triplo098/USB-to-Multipurpose-Framework-Expansion-Card/usb_to_multipurpose/usb_to_multipurpose_with_case.png

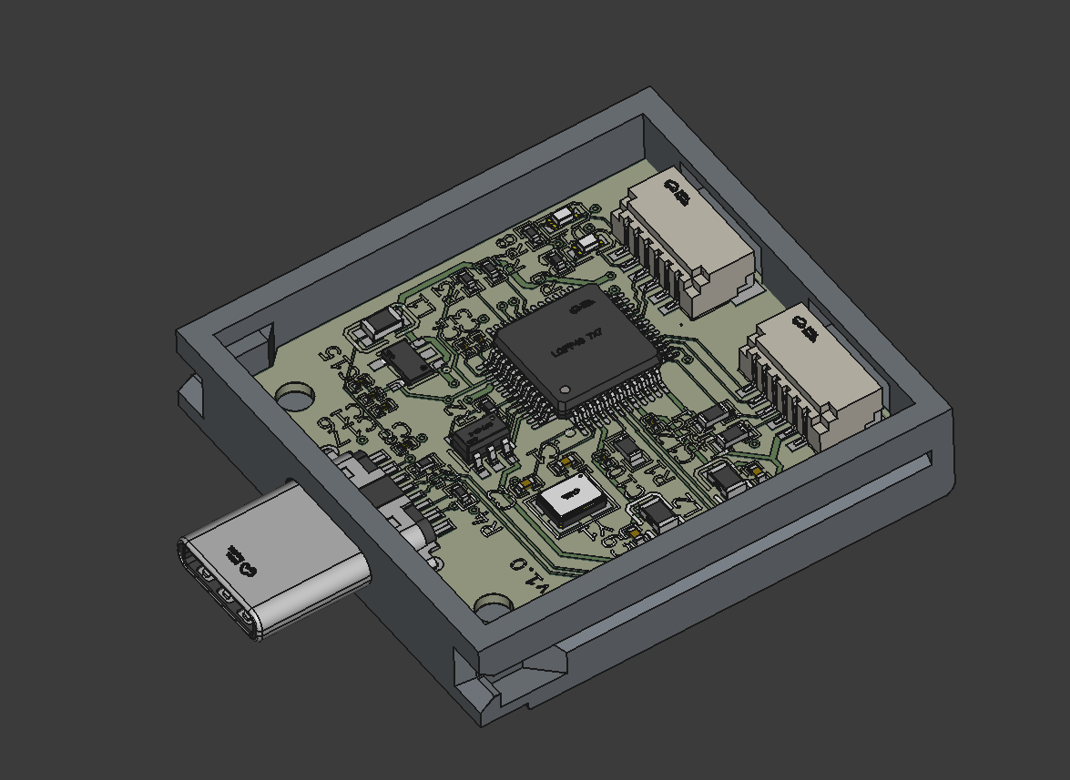
usb_to_multipurpose/usb_to_multipurpose_with_case.png
