triplo098/USB-to-Multipurpose-Framework-Expansion-Card/3D_models/usb_to_multipurpose.stl

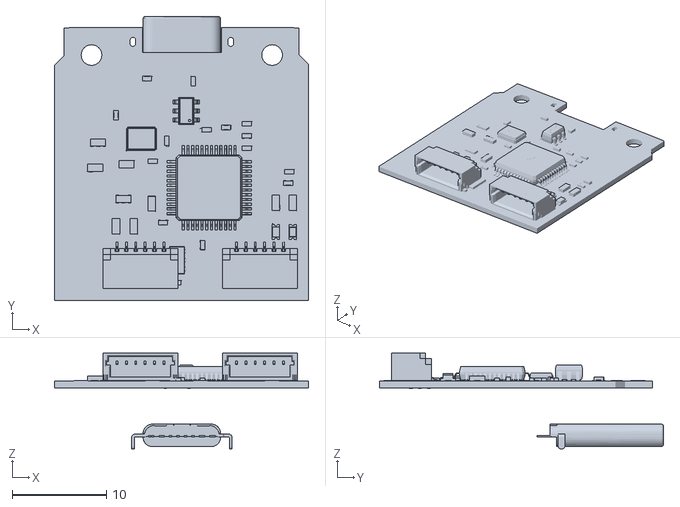
[picture p6: CAD file, 2026-11-10]
3D_models/usb_to_multipurpose.stl
27.0 x 30.2 x 10.2
