triplo098/USB-to-Multipurpose-Framework-Expansion-Card/usb_to_multipurpose/usb_to_multipurpose.step

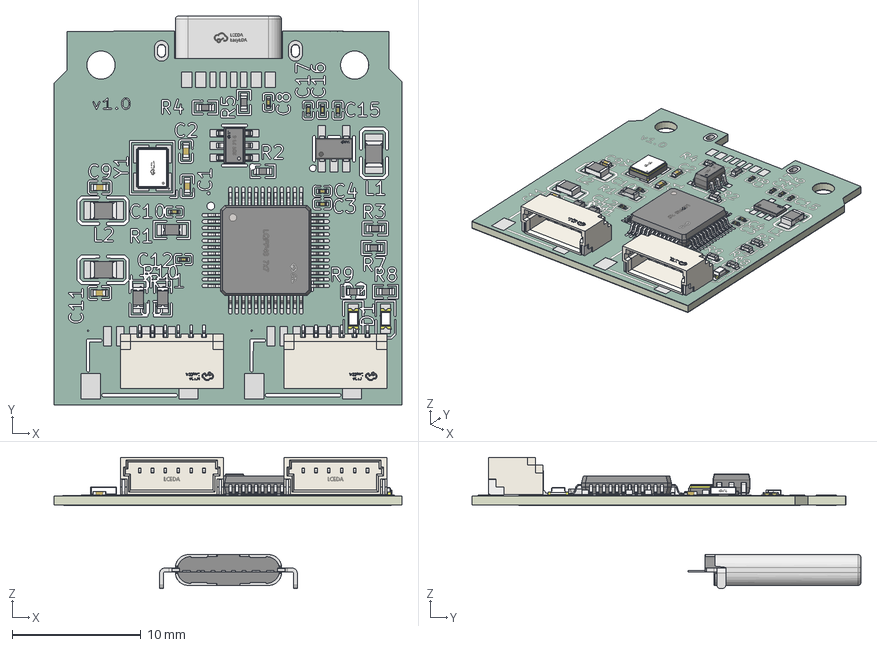
[picture p7: CAD file, 2026-11-04]
usb_to_multipurpose/usb_to_multipurpose.step
27.0 x 30.2 x 10.2 mm
R0402_L1.0-W0.5-H0.4 x 7
C0402_L1.0-W0.5-H0.5 x 4
R0603 x 3
C0201_L0.6-W0.3-H0.3 x 8
R0805_L2.0-W1.3-H0.6 x 3
CONN-SMD_SR1.00-WS-6P x 2
LQFP-48_L7.0-W7.0-H1.4-LS9.0-P0.50
LED0603-RD x 2
SOT-23-6_L2.9-W1.6-H1.5-LS2.8-P0.95
SOT-23-5_L2.9-W1.6-P0.95-LS2.7-BR
USB-C-SMD_HYCW675-USBC12-105B
OSC-SMD_4P-L3.2-W2.5-CJ13-320001210A20
usb_to_multipurpose_copper
usb_to_multipurpose_pad
usb_to_multipurpose_via
usb_to_multipurpose_silkscreen
usb_to_multipurpose_soldermask x 2
usb_to_multipurpose_PCB
