triplo098/USB-to-Multipurpose-Framework-Expansion-Card/3D_models/cover.stl

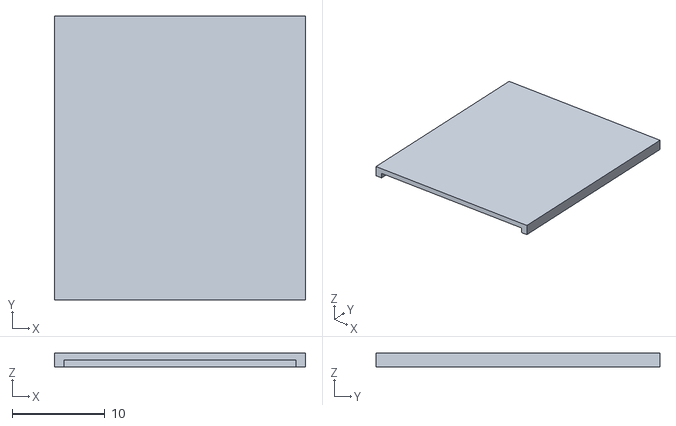
[picture p8: CAD file, 2026-11-10]
3D_models/cover.stl
27.0 x 30.5 x 1.50
