triplo098/USB-to-Multipurpose-Framework-Expansion-Card/3D_models/case.stl

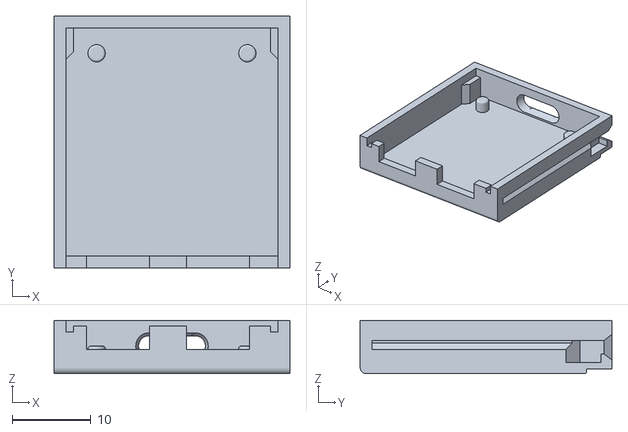
[picture p9: CAD file, 2026-11-10]
3D_models/case.stl
30.0 x 32.0 x 6.80
