triplo098/USB-to-Multipurpose-Framework-Expansion-Card/3D_models/base.FCStd

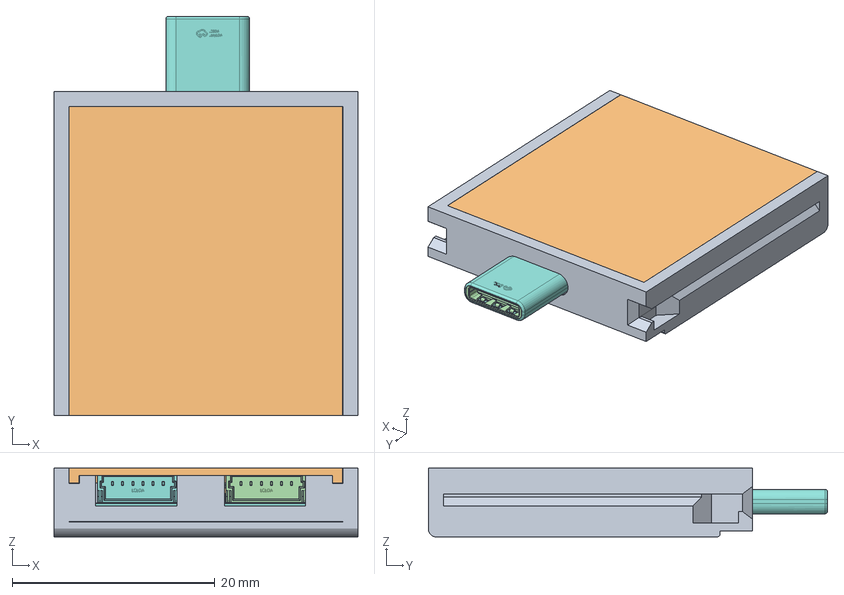
[picture p10: CAD file, 2026-11-10]
3D_models/base.FCStd
30.0 x 39.4 x 6.80 mm
R0402_L1.0-W0.5-H0.4
R0402_L1.0-W0.5-H0.005
R0402_L1.0-W0.5-H0.006
C0402_L1.0-W0.5-H0.5
R0603
R0604
R0605
R0606
L0603_L1.6-W0.8-H0.5_BEAD
R0609
R0610
R0611
R0612
C0402_L1.0-W0.5-H0.007
C0402_L1.0-W0.5-H0.009
C0402_L1.0-W0.5-H0.011
R0615
R0616
R0617
R0618
SOT-23-5_L2.9-W1.6-P0.95-LS2.7-BR
SOT-23-5_L2.9-W1.6-P0.95-LS2.7-BR001
SOT-23-5_L2.9-W1.6-P0.95-LS2.7-BR002
SOT-23-5_L2.9-W1.6-P0.95-LS2.7-BR003
SOT-23-5_L2.9-W1.6-P0.95-LS2.7-BR004
SOT-23-5_L2.9-W1.6-P0.95-LS2.7-BR005
SOT-23-5_L2.9-W1.6-P0.95-LS2.7-BR006
SOT-23-5_L2.9-W1.6-P0.95-LS2.7-BR007
SOT-23-5_L2.9-W1.6-P0.95-LS2.7-BR008
SOT-23-5_L2.9-W1.6-P0.95-LS2.7-BR009
SOT-23-5_L2.9-W1.6-P0.95-LS2.7-BR010
SOT-23-5_L2.9-W1.6-P0.95-LS2.7-BR011
SOT-23-5_L2.9-W1.6-P0.95-LS2.7-BR012
SOT-23-5_L2.9-W1.6-P0.95-LS2.7-BR013
C0603_L1.6-W0.8-H0.8
CONN-SMD_SR1.00-WS-6P
CONN-SMD_SR1.00-WS-6P001
CONN-SMD_SR1.00-WS-6P002
CONN-SMD_SR1.00-WS-6P003
CONN-SMD_SR1.00-WS-6P004
CONN-SMD_SR1.00-WS-6P005
CONN-SMD_SR1.00-WS-6P006
CONN-SMD_SR1.00-WS-6P007
CONN-SMD_SR1.00-WS-6P008
CONN-SMD_SR1.00-WS-6P009
CONN-SMD_SR1.00-WS-6P010
CONN-SMD_SR1.00-WS-6P011
CONN-SMD_SR1.00-WS-6P012
CONN-SMD_SR1.00-WS-6P013
LQFP-48_L7.0-W7.0-H1.4-LS9.0-P0.50
LQFP-48_L7.0-W7.0-H1.4-LS9.0-P0.051
LQFP-48_L7.0-W7.0-H1.4-LS9.0-P0.052
LQFP-48_L7.0-W7.0-H1.4-LS9.0-P0.053
LQFP-48_L7.0-W7.0-H1.4-LS9.0-P0.054
LQFP-48_L7.0-W7.0-H1.4-LS9.0-P0.055
LQFP-48_L7.0-W7.0-H1.4-LS9.0-P0.056
LQFP-48_L7.0-W7.0-H1.4-LS9.0-P0.057
LQFP-48_L7.0-W7.0-H1.4-LS9.0-P0.058
LQFP-48_L7.0-W7.0-H1.4-LS9.0-P0.059
LQFP-48_L7.0-W7.0-H1.4-LS9.0-P0.060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
