triplo098/USB-to-Multipurpose-Framework-Expansion-Card/3D_models/ExpansionCard.scad

  

<!DOCTYPE html>
<html
  lang="en"
  
  data-color-mode="auto" data-light-theme="light" data-dark-theme="dark"
  data-a11y-animated-images="system" data-a11y-link-underlines="true"
  
  >




  <head>
    <meta charset="utf-8">
  <link rel="dns-prefetch" href="https://github.githubassets.com">
  <link rel="dns-prefetch" href="https://avatars.githubusercontent.com">
  <link rel="dns-prefetch" href="https://github-cloud.s3.amazonaws.com">
  <link rel="dns-prefetch" href="https://user-images.githubusercontent.com/">
  <link rel="preconnect" href="https://github.githubassets.com" crossorigin>
  <link rel="preconnect" href="https://avatars.githubusercontent.com">

<script type="importmap">{"imports":{"react":"https://github.githubassets.com/assets/react-e27d1b3e03961e68.js","react-dom":"https://github.githubassets.com/assets/react-dom-e5fd46a22d5c4058.js","react-dom/client":"https://github.githubassets.com/assets/react-dom-client-1b4a3ee065998cea.js","react-is":"https://github.githubassets.com/assets/react-is-e0b593954b4706d8.js","react-reconciler":"https://github.githubassets.com/assets/react-reconciler-8e99e505c4429605.js","react/compiler-runtime":"https://github.githubassets.com/assets/react-compiler-runtime-4610bd6d3de9c049.js","react/jsx-dev-runtime":"https://github.githubassets.com/assets/react-jsx-dev-runtime-ea55d68667d559e5.js","react/jsx-runtime":"https://github.githubassets.com/assets/react-jsx-runtime-4915cb0f5b3aff04.js","scheduler":"https://github.githubassets.com/assets/scheduler-58b860b049ca307c.js"}}</script>
<meta name="react-profiling" content="0" data-turbo-transient="true" />
<meta name="react-import-map" content="react,react-dom,react-dom/client,react-dom/profiling,react-is,react-reconciler,react/compiler-runtime,react/jsx-dev-runtime,react/jsx-runtime,scheduler@777f63f87cd0" data-turbo-track="reload" />
<link crossorigin="anonymous" rel="modulepreload" href="https://github.githubassets.com/assets/react-e27d1b3e03961e68.js" />
<link crossorigin="anonymous" rel="modulepreload" href="https://github.githubassets.com/assets/react-compiler-runtime-4610bd6d3de9c049.js" />
<link crossorigin="anonymous" rel="modulepreload" href="https://github.githubassets.com/assets/scheduler-58b860b049ca307c.js" />
<link crossorigin="anonymous" rel="modulepreload" href="https://github.githubassets.com/assets/react-dom-e5fd46a22d5c4058.js" />
<link crossorigin="anonymous" rel="modulepreload" href="https://github.githubassets.com/assets/react-dom-client-1b4a3ee065998cea.js" />
<link crossorigin="anonymous" rel="modulepreload" href="https://github.githubassets.com/assets/react-is-e0b593954b4706d8.js" />
<link crossorigin="anonymous" rel="modulepreload" href="https://github.githubassets.com/assets/react-jsx-runtime-4915cb0f5b3aff04.js" />
<link crossorigin="anonymous" rel="modulepreload" href="https://github.githubassets.com/assets/react-reconciler-8e99e505c4429605.js" />

  


  <link crossorigin="anonymous" media="all" rel="stylesheet" href="https://github.githubassets.com/assets/light-99f877e9ddfc0e51.css" /><link crossorigin="anonymous" media="all" rel="stylesheet" href="https://github.githubassets.com/assets/light_high_contrast-48fdd0811afbab3c.css" /><link crossorigi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

  <style type="text/css">
    :root {
      --tab-size-preference: 4;
    }

    pre, code {
      tab-size: var(--tab-size-preference);
    }
  </style>

    <link crossorigin="anonymous" media="all" rel="stylesheet" href="https://github.githubassets.com/assets/primer-primitives-ed9ca172356fd545.css" />
    <link crossorigin="anonymous" media="all" rel="stylesheet" href="https://github.githubassets.com/assets/primer-1d2c7f7b52a6068b.css" />
    <link crossorigin="anonymous" media="all" rel="stylesheet" href="https://github.githubassets.com/assets/global-54ba76e934a49d7c.css" />
    <link crossorigin="anonymous" media="all" rel="stylesheet" href="https://github.githubassets.com/assets/github-9a507bf7e8541e19.css" />
  <link crossorigin="anonymous" media="all" rel="stylesheet" href="https://github.githubassets.com/assets/repository-11ee8a031c040c1a.css" />
<link crossorigin="anonymous" media="all" rel="stylesheet" href="https://github.githubassets.com/assets/code-2d56bdb0166c0238.css" />

  

  <script type="application/json" id="client-env">{"locale":"en","featureFlags":["actions_enable_background_steps","actions_new_hosted_runner_image_select_sizes_and_versions","activity_diff_file_tree","activity_repos_file_tree","activity_repos_overview_header","activity_repos_overview_sidebar","agent_author_search_expansion","agent_author_search_expansion_ui_pulls","alternate_user_config_repo","async_conversion_coverage_enabled","billing_billable_licenses_cost_center_bucket_fix","billing_budget_expiration","billing_cost_center_list_assigned_resources","billing_discount_threshold_notification","code_quality_enablement_banner_targeting","code_quality_remove_preview","code_view_raf_sticky_lines","codespaces_prebuild_region_target_update","coding_agent_third_party_model_ui","copilot_agent_snippy","copilot_api_agentic_issue_marshal_yaml","copilot_automations_pagination","copilot_chat_auto_mode_v2","copilot_chat_clear_model_selection_for_default_change","copilot_chat_header_reorder","copilot_chat_max_upsell","copilot_chat_minimize_contextual","copilot_chat_models_browser_cache","copilot_chat_reduce_quota_checks","copilot_chat_vision_dotcom_chat_ga_gate","copilot_chat_vision_preview_gate","copilot_css_textarea_autosize","copilot_custom_copilots","copilot_custom_copilots_feature_preview","copilot_duplicate_thread","copilot_extensions_removal_on_marketplace","copilot_fix_failed_workflows_all_skus","copilot_ftp_hyperspace_upgrade_prompt","copilot_hide_hovercard","copilot_immersive_code_block_transition_wrap","copilot_immersive_embedded_draggable","copilot_immersive_embedded_header_button","copilot_immersive_file_block_transition_open","copilot_immersive_file_preview_keep_mounted","copilot_immersive_suggestion_pills","copilot_immersive_task_hyperlinking","copilot_immersive_task_within_chat_thread","copilot_mc_cli_resume_any_users_task","copilot_mission_control_agent_merge_fix_ci","copilot_mission_control_agent_merge_resolve_conflicts","copilot_mission_control_agents_repository_enablement","copilot_mission_control_early_stop","copilot_mission_control_environment_list_icons","copilot_mission_control_managed_sandbox_environments","copilot_mission_control_needs_attention","copilot_mission_control_reasoning_effort","copilot_mission_control_repo_hovercards","copilot_mission_control_sandbox_client_side_clone","copilot_mission_control_sandbox_remote_bypass","copilot_mission_control_session_filters","copilot_mission_control_task_alive_updates","copilot_mission_control_task_sharing","copilot_org_policy_page_focus_mode","copilot_pr_chat_enhancements","copilot_prominent_upgrade_button","copilot_resource_panel","copilot_share_active_subthread","copilot_spaces_ga","copilot_spaces_individual_policies_ga","copilot_spark_handle_nil_friendly_name","copilot_swe_agent_authorization_status_ui","copilot_swe_agent_automation_resource_scoped_writes","copilot_swe_agent_hide_model_picker_if_only_auto","copilot_swe_agent_issue_comment_trigger","copilot_swe_agent_pr_comment_model_picker","copilot_swe_agent_pull_request_comment_trigger","copilot_swe_agent_pull_request_merged_trigger","copilot_swe_agent_pull_request_opened_trigger","copilot_swe_agent_pull_request_synchronize_trigger","copilot_swe_agent_use_subagents","copilot_task_api_github_rest_style","copilot_task_scoped_alive_channel","copilot_token_based_billing","copilot_unconfigured_is_inherited","copilot_user_can_upgrade_plan_field","copilot_workbench_sunset","copilot_workbench_sunset_redirect","copilot_workbench_ubb","dashboard_indexeddb_caching","dashboard_lists_max_age_filter","dashboard_universe_2025_feedback_dialog","glc_code_quality_repo_settings_workflow_config","hide_github_models_ui","hyperspace_2025_logged_out_batch_1","hyperspace_2025_logged_out_batch_2","hyperspace_2025_logged_out_batch_3","in_product_messaging_datadog_monitoring","ipm_global_transactional_message_copilot","ipm_global_transactional_message_issues","ipm_global_transactional_message_prs","ipm_global_transactional_message_repos","ipm_global_transactional_message_spaces","ipm_ubb_individual_budget_banner","issue_fields_multi_select","issue_inline_avatars","issue_pinned_views","issue_pinned_views_optimistic_updates","issue_relative_time_micro","issues_dashboard_sso_structured_errors","issues_expanded_file_types","issues_hide_closed_sub_issues","issues_lazy_load_comment_box_suggestions","issues_react_chrome_container_query_fix","labels_archiving","labels_archiving_info","landing_pages_ninetailed","lifecycle_label_name_updates","marketing_cookie_consent_banner","marketing_pages_search_explore_provider","memex_default_issue_create_repository","memex_lazy_hydrate_agent_tasks","memex_live_update_hovercard","memex_mwl_filter_field_delimiter","memex_remove_deprecated_type_issue","merge_queue_restricted_pushers_warning","merge_status_checks_refetch_dedupe","merge_status_header_feedback","oauth_authorize_clickjacking_protection","octocaptcha_origin_optimization","primer_react_css_anchor_positioning","primer_react_merged_forwarded_refs","prs_copilot_app_open_action","prs_css_anchor_positioning","pull_request_copilot_attribution_header","pull_request_overview_panel_edit_description","pull_request_persister","pull_request_stacks_feedback_dialog","pull_request_virtualization_image_estimate","pull_request_virtualization_scroll_compensation","pull_request_virtualization_scroll_intent","pulls_dashboard_sidebar_layout","quick_search_lazy_suggestions","react_blob_isolate_code_lines","react_blob_ssr_content_visibility","react_data_router_tanstack_allowed","react_query_props_with_key","react_sandbox_future_tanstack","repo_app_turbo","repo_issues_sidebar_layout","repo_overview_ask_copilot","repo_pulls_dashboard_persistence","repos_contributors_limited_default_range","review_involves_filter","rule_ignored_file_paths","rulesets_actor_list_editor","sample_network_conn_type","security_center_artifact_filters_popover","see_who_reacted","semantic_similarity_duplicate_issue_detection","session_logs_ungroup_reasoning_text","set_sha256_on_repo_creation_form","site_banner_desktop_copilot_app","site_ghca_pixel_mona","site_github_app_ga_page","site_github_app_ga_page_highlight","site_github_app_mobile_native_share","site_global_banner_dev_days_attendee","site_global_banner_learn_copilot_sdk","site_global_nav_spark_models_removed","spark_prompt_secret_scanning","spark_server_connection_status","suggest_custom_property_values_copilot","suppress_automated_browser_vitals","swp_forms_disable_octocaptcha","thread_resolution_reason","ui_service_referrer_metrics","ui_service_staleness_detection","update_issue_suggestions","user_code_paste_ux","viewscreen_sandbox","warn_inaccessible_attachments","webp_support","workbench_store_readonly","workstream_plugin_bootstrap"],"githubDomain":"https://github.com","copilotApiOverrideUrl":"https://api.githubcopilot.com","cmcApiUrl":"https://api.github.com/cmc_internal/api"}</script>
<script crossorigin="anonymous" type="module" src="https://github.githubassets.com/assets/high-contrast-cookie-e3d808ee18eb9784.js"></script>
<link crossorigin="anonymous" rel="modulepreload" href="https://github.githubassets.com/assets/wp-runtime-c9491513048445f5.js" />
<link crossorigin="anonymous" rel="modulepreload" href="https://github.githubassets.com/assets/app-foundation-74e9766bd696d26a.js" />
<link crossorigin="anonymous" rel="modulepreload" href="https://github.githubassets.com/assets/app-runtime-eed8df9c2267c378.js" />
<link crossorigin="anonymous" rel="modulepreload" href="https://github.githubassets.com/assets/fetch-utilities-5305162aa9984914.js" />
<link crossorigin="anonymous" rel="modulepreload" href="https://github.githubassets.com/assets/ser-cd1b421ad0ad7ed5.js" />
<script crossorigin="anonymous" type="module" src="https://github.githubassets.com/assets/environment-e79d47a77386b48e.js" defer="defer"></script>
<link crossorigin="anonymous" media="all" rel="stylesheet" href="https://github.githubassets.com/assets/app-runtime.94e436d05b4d028c.module.css" />
<link crossorigin="anonymous" rel="modulepreload" href="https://github.githubassets.com/assets/catalyst-86a8f5de995615f8.js" />
<link crossorigin="anonymous" rel="modulepreload" href="https://github.githubassets.com/assets/selector-observer-e88088f989b27670.js" />
<link crossorigin="anonymous" rel="modulepreload" href="https://github.githubassets.com/assets/relative-time-element-7cdf4e0db98b997c.js" />
<link crossorigin="anonymous" rel="modulepreload" href="https://github.githubassets.com/assets/by-6b3c07383371bf58.js" />
<link crossorigin="anonymous" rel="modulepreload" href="https://github.githubassets.com/assets/ja9-36f036c13c2e3a4c.js" />
<link crossorigin="anonymous" rel="modulepreload" href="https://github.githubassets.com/assets/kw-866fd9513ae95106.js" />
<link crossorigin="anonymous" rel="modulepreload" href="https://github.githubassets.com/assets/r1-b075aab3204f32f9.js" />
<link crossorigin="anonymous" rel="modulepreload" href="https://github.githubassets.com/assets/jz5-7c5d1669717041f8.js" />
<link crossorigin="anonymous" rel="modulepreload" href="https://github.githubassets.com/assets/hj-5126390ff433704d.js" />
<link crossorigin="anonymous" rel="modulepreload" href="https://github.githubassets.com/assets/j05-dce4d588268f0f7e.js" />
<script crossorigin="anonymous" type="module" src="https://github.githubassets.com/assets/github-elements-78519e355dd73160.js" defer="defer"></script>
<script crossorigin="anonymous" type="module" src="https://github.githubassets.com/assets/element-registry-d61d36bd852a688e.js" defer="defer"></script>
<link crossorigin="anonymous" rel="modulepreload" href="https://github.githubassets.com/assets/runtime-helpers-f3f5d71440009c48.js" />
<link crossorigin="anonymous" rel="modulepreload" href="https://github.githubassets.com/assets/aria-live-76b18916d0c8ec4d.js" />
<link crossorigin="anonymous" rel="modulepreload" href="https://github.githubassets.com/assets/hotkey-5109c77d7ac61078.js" />
<link crossorigin="anonymous" rel="modulepreload" href="https://github.githubassets.com/assets/react-core-1e7c54cd6a10b9af.js" />
<link crossorigin="anonymous" rel="modulepreload" href="https://github.githubassets.com/assets/04-9cb1f09b927a3a68.js" />
<link crossorigin="anonymous" rel="modulepreload" href="https://github.githubassets.com/assets/urv-b9498edf8699ddd8.js" />
<link crossorigin="anonymous" rel="modulepreload" href="https://github.githubassets.com/assets/4t-364e19c63d726e9a.js" />
<link crossorigin="anonymous" rel="modulepreload" href="https://github.githubassets.com/assets/6ny-c969fbae697a356f.js" />
<link crossorigin="anonymous" rel="modulepreload" href="https://github.githubassets.com/assets/yhq-3a209035a30b1a09.js" />
<link crossorigin="anonymous" rel="modulepreload" href="https://github.githubassets.com/assets/z1v-da5b33b877bfa358.js" />
<link crossorigin="anonymous" rel="modulepreload" href="https://github.githubassets.com/assets/wo-09f85d22a6c8931b.js" />
<link crossorigin="anonymous" rel="modulepreload" href="https://github.githubassets.com/assets/9y-81cfe57dc9040f3e.js" />
<link crossorigin="anonymous" rel="modulepreload" href="https://github.githubassets.com/assets/j0-41a4cf04cbd99503.js" />
<link crossorigin="anonymous" rel="modulepreload" href="https://github.githubassets.com/assets/0p-81491ed0d9d666e2.js" />
<script crossorigin="anonymous" type="module" src="https://github.githubassets.com/assets/behaviors-a0734869118d72e1.js" defer="defer"></script>
<link crossorigin="anonymous" media="all" rel="stylesheet" href="https://github.githubassets.com/assets/react-core.208b5f495e9f1db4.module.css" />
<script crossorigin="anonymous" type="module" src="https://github.githubassets.com/assets/code-menu-151bf4adedbf9805.js" defer="defer"></script>
  
  <link crossorigin="anonymous" rel="modulepreload" href="https://github.githubassets.com/assets/primer-react-0453988544916903.js" />
<link crossorigin="anonymous" rel="modulepreload" href="https://github.githubassets.com/assets/ncx-9a860680a5f230b9.js" />
<link crossorigin="anonymous" rel="modulepreload" href="https://github.githubassets.com/assets/j6-363f0ebf4f62f310.js" />
<link crossorigin="anonymous" rel="modulepreload" href="https://github.githubassets.com/assets/t7l-bf6f21d7e7a43c35.js" />
<link crossorigin="anonymous" rel="modulepreload" href="https://github.githubassets.com/assets/fe-7576d9b281e2106a.js" />
<link crossorigin="anonymous" rel="modulepreload" href="https://github.githubassets.com/assets/wsr-5fd3071e5a9061ab.js" />
<link crossorigin="anonymous" rel="modulepreload" href="https://github.githubassets.com/assets/0n-ecadb2ffe6b01ba2.js" />
<link crossorigin="anonymous" rel="modulepreload" href="https://github.githubassets.com/assets/xv-51cb34754bda73a9.js" />
<link crossorigin="anonymous" rel="modulepreload" href="https://github.githubassets.com/assets/n4u-6317ce1c31aed1db.js" />
<link crossorigin="anonymous" rel="modulepreload" href="https://github.githubassets.com/assets/j8s-d90ce3a169b741ed.js" />
<link crossorigin="anonymous" rel="modulepreload" href="https://github.githubassets.com/assets/la-de176c4ee471f2b3.js" />
<link crossorigin="anonymous" rel="modulepreload" href="https://github.githubassets.com/assets/43-6eded7522a998126.js" />
<link crossorigin="anonymous" rel="modulepreload" href="https://github.githubassets.com/assets/y2-87df441f1bc5a264.js" />
<link crossorigin="anonymous" rel="modulepreload" href="https://github.githubassets.com/assets/d6-43637518e8caa698.js" />
<link crossorigin="anonymous" rel="modulepreload" href="https://github.githubassets.com/assets/2b-3aab547015e99a2e.js" />
<link crossorigin="anonymous" rel="modulepreload" href="https://github.githubassets.com/assets/mgq-93f58f229b2328b4.js" />
<link crossorigin="anonymous" rel="modulepreload" href="https://github.githubassets.com/assets/on-95be29ba1ef725d9.js" />
<link crossorigin="anonymous" rel="modulepreload" href="https://github.githubassets.com/assets/bi0-e2f78de823e39ca9.js" />
<link crossorigin="anonymous" rel="modulepreload" href="https://github.githubassets.com/assets/b1-1dbc371cef78c3c1.js" />
<link crossorigin="anonymous" rel="modulepreload" href="https://github.githubassets.com/assets/0l5-629d8eb51aea8084.js" />
<link crossorigin="anonymous" rel="modulepreload" href="https://github.githubassets.com/assets/c2z-c92998400310b94b.js" />
<link crossorigin="anonymous" rel="modulepreload" href="https://github.githubassets.com/assets/f9-038758dcbfe08dab.js" />
<link crossorigin="anonymous" rel="modulepreload" href="https://github.githubassets.com/assets/0k-b7df0a74912a42bf.js" />
<link crossorigin="anonymous" rel="modulepreload" href="https://github.githubassets.com/assets/sp-2bbb73a69162e23b.js" />
<link crossorigin="anonymous" rel="modulepreload" href="https://github.githubassets.com/assets/og-93ae8b358505d372.js" />
<link crossorigin="anonymous" rel="modulepreload" href="https://github.githubassets.com/assets/b9-69d9b60a1b1fcd59.js" />
<link crossorigin="anonymous" rel="modulepreload" href="https://github.githubassets.com/assets/ec-ec74cb1fa6c31a3f.js" />
<link crossorigin="anonymous" rel="modulepreload" href="https://github.githubassets.com/assets/du-bbe0f39cd2abe9a0.js" />
<link crossorigin="anonymous" rel="modulepreload" href="https://github.githubassets.com/assets/ql0-6accb9e40c25a6a5.js" />
<link crossorigin="anonymous" rel="modulepreload" href="https://github.githubassets.com/assets/20-3f5f5824eb51c5f6.js" />
<link crossorigin="anonymous" rel="modulepreload" href="https://github.githubassets.com/assets/dsj-cb1e4ddbce4f007b.js" />
<link crossorigin="anonymous" rel="modulepreload" href="https://github.githubassets.com/assets/wp-9f5235d335ab624b.js" />
<link crossorigin="anonymous" rel="modulepreload" href="https://github.githubassets.com/assets/ko6-9e80f7ac359e3c43.js" />
<link crossorigin="anonymous" rel="modulepreload" href="https://github.githubassets.com/assets/uw-8c275f7ac25b7cf6.js" />
<link crossorigin="anonymous" rel="modulepreload" href="https://github.githubassets.com/assets/bsb-4f4ac8c20da73fac.js" />
<link crossorigin="anonymous" rel="modulepreload" href="https://github.githubassets.com/assets/w5-b6a7935106c47137.js" />
<link crossorigin="anonymous" rel="modulepreload" href="https://github.githubassets.com/assets/fm-e8431b09538b6a7f.js" />
<link crossorigin="anonymous" rel="modulepreload" href="https://github.githubassets.com/assets/z-1081c2a87e2eaecc.js" />
<link crossorigin="anonymous" rel="modulepreload" href="https://github.githubassets.com/assets/h0-010921512138e12f.js" />
<link crossorigin="anonymous" rel="modulepreload" href="https://github.githubassets.com/assets/5p-ae5db0820116fb43.js" />
<link crossorigin="anonymous" rel="modulepreload" href="https://github.githubassets.com/assets/8vq-b2af216e992e11ef.js" />
<link crossorigin="anonymous" rel="modulepreload" href="https://github.githubassets.com/assets/g5-d3fd34c7e46e378a.js" />
<link crossorigin="anonymous" rel="modulepreload" href="https://github.githubassets.com/assets/xc-f5d51b571cd317cb.js" />
<link crossorigin="anonymous" rel="modulepreload" href="https://github.githubassets.com/assets/arw-51e8918a1b75a80f.js" />
<script crossorigin="anonymous" type="module" src="https://github.githubassets.com/assets/code-view-ed430eccfffe2303.js" defer="defer"></script>
<link crossorigin="anonymous" media="all" rel="stylesheet" href="https://github.githubassets.com/assets/primer-react-css.7c5f404947919942.module.css" />
<link crossorigin="anonymous" media="all" rel="stylesheet" href="https://github.githubassets.com/assets/ql0.bd9e6b542f167fd8.module.css" />
<link crossorigin="anonymous" media="all" rel="stylesheet" href="https://github.githubassets.com/assets/z.6ca215cd00aa635b.module.css" />
<link crossorigin="anonymous" media="all" rel="stylesheet" href="https://github.githubassets.com/assets/xc.13e027137438fd9f.module.css" />
<link crossorigin="anonymous" media="all" rel="stylesheet" href="https://github.githubassets.com/assets/code-view.53d6c436cce1e2dd.module.css" />

  <link crossorigin="anonymous" rel="modulepreload" href="https://github.githubassets.com/assets/hu-1fc0b2a167afc025.js" />
<link crossorigin="anonymous" rel="modulepreload" href="https://github.githubassets.com/assets/fbr-ac48bf596ce02661.js" />
<script crossorigin="anonymous" type="module" src="https://github.githubassets.com/assets/notifications-subscriptions-menu-991fa50f0a616e5c.js" defer="defer"></script>
<link crossorigin="anonymous" media="all" rel="stylesheet" href="https://github.githubassets.com/assets/primer-react-css.7c5f404947919942.module.css" />
<link crossorigin="anonymous" media="all" rel="stylesheet" href="https://github.githubassets.com/assets/notifications-subscriptions-menu.e6bebc1a04ca0ece.module.css" />


  <title>ExpansionCards/Mechanical/OpenSCAD/ExpansionCard.scad at main · FrameworkComputer/ExpansionCards · GitHub</title>



  <meta name="route-pattern" content="/:user_id/:repository/blob/*name(/*path)" data-turbo-transient>
  <meta name="route-controller" content="blob" data-turbo-transient>
  <meta name="route-action" content="show" data-turbo-transient>
  <meta name="fetch-nonce" content="v2:9af80e55-5b1d-9828-e897-66106c8df3fe">

    
  <meta name="current-catalog-service-hash" content="f3abb0cc802f3d7b95fc8762b94bdcb13bf39634c40c357301c4aa1d67a256fb">


  <meta name="request-id" content="DB00:38F55:3C7EA5:3501BE:6AAAD501" data-pjax-transient="true"/><meta name="html-safe-nonce" content="8b419a998e4e6e70520c35a48716070ca520a97ffbe878722149b87e0ad8b0c7" data-pjax-transient="true"/><meta name="visitor-payload" content="eyJyZWZlcnJlciI6IiIsInJlcXVlc3RfaWQiOiJEQjAwOjM4RjU1OjNDN0VBNTozNTAxQkU6NkFBQUQ1MDEiLCJ2aXNpdG9yX2lkIjoiNjAyMjc3OTUzMzY5OTc2NTUwNSIsInJlZ2lvbl9lZGdlIjoiZnJhIiwicmVnaW9uX3JlbmRlciI6ImZyYSJ9" data-pjax-transient="true"/><meta name="visitor-hmac" content="3d5ab1451334bd2dca876e64e68d4b3104ab469578886b940030a51ff5fb924e" data-pjax-transient="true"/>


    <meta name="hovercard-subject-tag" content="repository:368059461" data-turbo-transient>


  <meta name="github-keyboard-shortcuts" content="repository,source-code,file-tree,copilot" data-turbo-transient="true" />
  

  <meta name="selected-link" value="repo_source" data-turbo-transient>
  <link rel="assets" href="https://github.githubassets.com/">

    <meta name="google-site-verification" content="Apib7-x98H0j5cPqHWwSMm6dNU4GmODRoqxLiDzdx9I">

<meta name="octolytics-url" content="https://collector.github.com/github/collect" />





  <meta name="analytics-location" content="/&lt;user-name&gt;/&lt;repo-name&gt;/blob/show" data-turbo-transient="true" />

  




    <meta name="user-login" content="">

  

    <meta name="viewport" content="width=device-width">

    

      <meta name="description" content="Reference designs and documentation to create Expansion Cards for the Framework Laptop - ExpansionCards/Mechanical/OpenSCAD/ExpansionCard.scad at main · FrameworkComputer/ExpansionCards">

      <link rel="search" type="application/opensearchdescription+xml" href="/opensearch.xml" title="GitHub">

    <link rel="fluid-icon" href="https://github.com/fluidicon.png" title="GitHub">
    <meta property="fb:app_id" content="1401488693436528">
    <meta name="apple-itunes-app" content="app-id=1477376905, app-argument=https://github.com/FrameworkComputer/ExpansionCards/blob/main/Mechanical/OpenSCAD/ExpansionCard.scad" />

      <meta name="twitter:image" content="https://repository-images.githubusercontent.com/368059461/1c482900-c9ca-11eb-8c47-cbfb7c47484f" /><meta name="twitter:site" content="@github" /><meta name="twitter:card" content="summary_large_image" /><meta name="twitter:title" content="ExpansionCards/Mechanical/OpenSCAD/ExpansionCard.scad at main · FrameworkComputer/ExpansionCards" /><meta name="twitter:description" content="Reference designs and documentation to create Expansion Cards for the Framework Laptop - FrameworkComputer/ExpansionCards" />
  <meta property="og:image" content="https://repository-images.githubusercontent.com/368059461/1c482900-c9ca-11eb-8c47-cbfb7c47484f" /><meta property="og:image:alt" content="Reference designs and documentation to create Expansion Cards for the Framework Laptop - FrameworkComputer/ExpansionCards" /><meta property="og:site_name" content="GitHub" /><meta property="og:type" content="object" /><meta property="og:title" content="ExpansionCards/Mechanical/OpenSCAD/ExpansionCard.scad at main · FrameworkComputer/ExpansionCards" /><meta property="og:url" content="https://github.com/FrameworkComputer/ExpansionCards/blob/main/Mechanical/OpenSCAD/ExpansionCard.scad" /><meta property="og:description" content="Reference designs and documentation to create Expansion Cards for the Framework Laptop - FrameworkComputer/ExpansionCards" />
  




      <meta name="hostname" content="github.com">



        <meta name="expected-hostname" content="github.com">


  <meta http-equiv="x-pjax-version" content="745cd35bfed42df3b4d72e6aa893c98876ca8738786de0ad930dd9fd8f79e53f" data-turbo-track="reload">
  <meta http-equiv="x-pjax-csp-version" content="0c5c6e5334a905d8f9521e09eadcffba484d422e0d262e07ff922e6bc18b2ac6" data-turbo-track="reload">
  <meta http-equiv="x-pjax-css-version" content="df51ed03e8c211b80da914b9430eb5f4bacbc4fac89b541797c0e4d355273599" data-turbo-track="reload">
  <meta http-equiv="x-pjax-js-version" content="cb19dc02b2416ae962b46d4fed4a3e57901c5293532eb72e7b6e933ce540420e" data-turbo-track="reload">

  <meta name="turbo-cache-control" content="no-preview" data-turbo-transient="">

      <meta name="turbo-cache-control" content="no-cache" data-turbo-transient>

    <meta data-hydrostats="publish">

  <meta name="go-import" content="github.com/FrameworkComputer/ExpansionCards git https://github.com/FrameworkComputer/ExpansionCards.git">

  <meta name="octolytics-dimension-user_id" content="58124942" /><meta name="octolytics-dimension-user_login" content="FrameworkComputer" /><meta name="octolytics-dimension-repository_id" content="368059461" /><meta name="octolytics-dimension-repository_nwo" content="FrameworkComputer/ExpansionCards" /><meta name="octolytics-dimension-repository_public" content="true" /><meta name="octolytics-dimension-repository_is_fork" content="false" /><meta name="octolytics-dimension-repository_network_root_id" content="368059461" /><meta name="octolytics-dimension-repository_network_root_nwo" content="FrameworkComputer/ExpansionCards" />
  



    

    <meta name="turbo-body-classes" content="logged-out env-production page-responsive">
  <meta name="disable-turbo" content="false">


  <meta name="browser-stats-url" content="https://api.github.com/_private/browser/stats">


  <meta name="browser-errors-url" content="https://api.github.com/_private/browser/errors">

  <meta name="release" content="fa2d5921d439eff2cd0e3212955c45bbf7c564e5" data-turbo-track="reload">
  <meta name="ui-target" content="full">

  <link rel="mask-icon" href="https://github.githubassets.com/assets/pinned-octocat-093da3e6fa40.svg" color="#000000">
  <link rel="alternate icon" class="js-site-favicon" type="image/png" href="https://github.githubassets.com/favicons/favicon.png">
  <link rel="icon" class="js-site-favicon" type="image/svg+xml" href="https://github.githubassets.com/favicons/favicon.svg" data-base-href="https://github.githubassets.com/favicons/favicon">

<meta name="theme-color" content="#1e2327">
<meta name="color-scheme" content="light dark" />


  <link rel="manifest" href="/manifest.json" crossOrigin="use-credentials">

  </head>

  <body class="logged-out env-production page-responsive" style="word-wrap: break-word;" >
    <div data-turbo-body class="logged-out env-production page-responsive" style="word-wrap: break-word;" >
      <div id="__primerPortalRoot__" style="z-index: 1000; position: absolute; width: 100%;" data-turbo-permanent></div>
      

    <div class="position-relative header-wrapper js-header-wrapper ">
      <a href="#start-of-content" data-skip-target-assigned="false" class="px-2 tmp-py-4 color-bg-accent-emphasis color-fg-on-emphasis show-on-focus js-skip-to-content">Skip to content</a>

      <span data-view-component="true" class="progress-pjax-loader Progress position-fixed width-full">
    <span style="width: 0%;" data-view-component="true" class="Progress-item progress-pjax-loader-bar left-0 top-0 color-bg-accent-emphasis"></span>
</span>      
      <link crossorigin="anonymous" rel="modulepreload" href="https://github.githubassets.com/assets/l7j-2ddd8b435dadae28.js" fetchpriority="low" />
<link crossorigin="anonymous" rel="modulepreload" href="https://github.githubassets.com/assets/keyboard-shortcuts-dialog-99e1a64fd2fff101.js" fetchpriority="low" />
<link crossorigin="anonymous" media="all" rel="stylesheet" href="https://github.githubassets.com/assets/primer-react-css.7c5f404947919942.module.css" />
<link crossorigin="anonymous" media="all" rel="stylesheet" href="https://github.githubassets.com/assets/keyboard-shortcuts-dialog.76a88c301d929d65.module.css" />

<react-partial
  partial-name="keyboard-shortcuts-dialog"
  data-ssr="false"
  data-attempted-ssr="false"
  data-react-profiling="false"
>
  
  <script type="application/json" data-target="react-partial.embeddedData">{"props":{"docsUrl":"https://docs.github.com/get-started/accessibility/keyboard-shortcuts"}}</script>
  <div data-target="react-partial.reactRoot"></div>
</react-partial>





      

          
          

                <link crossorigin="anonymous" rel="modulepreload" href="https://github.githubassets.com/assets/2l-a4cd948f93d92068.js" fetchpriority="low" />
<link crossorigin="anonymous" rel="modulepreload" href="https://github.githubassets.com/assets/i26-de97ea9fb4f29e3b.js" fetchpriority="low" />
<link crossorigin="anonymous" rel="modulepreload" href="https://github.githubassets.com/assets/fz5-23f28c0f388769c9.js" fetchpriority="low" />
<link crossorigin="anonymous" rel="modulepreload" href="https://github.githubassets.com/assets/lht-26506ea833dda5be.js" fetchpriority="low" />
<link crossorigin="anonymous" rel="modulepreload" href="https://github.githubassets.com/assets/p1-76a75a6081059b19.js" fetchpriority="low" />
<link crossorigin="anonymous" rel="modulepreload" href="https://github.githubassets.com/assets/3d-82c347d20a13fb90.js" fetchpriority="low" />
<link crossorigin="anonymous" rel="modulepreload" href="https://github.githubassets.com/assets/tua-c4ca62c5e0e0318e.js" fetchpriority="low" />
<link crossorigin="anonymous" rel="modulepreload" href="https://github.githubassets.com/assets/4s-d5f4a92616cf44ce.js" fetchpriority="low" />
<link crossorigin="anonymous" rel="modulepreload" href="https://github.githubassets.com/assets/marketing-header-a8deb47efe9c7f7b.js" fetchpriority="low" />
<link crossorigin="anonymous" media="all" rel="stylesheet" href="https://github.githubassets.com/assets/primer-react-css.7c5f404947919942.module.css" />
<link crossorigin="anonymous" media="all" rel="stylesheet" href="https://github.githubassets.com/assets/primer-react-brand-css.6a01c236ff527e7e.module.css" />
<link crossorigin="anonymous" media="all" rel="stylesheet" href="https://github.githubassets.com/assets/4s.f5f0f10079b3ce36.module.css" />

<react-partial
  partial-name="marketing-header"
  data-ssr="true"
  data-attempted-ssr="true"
  data-react-profiling="false"
>
  
  <script type="application/json" data-target="react-partial.embeddedData">{"props":{"color_mode":"dark","logged_in":false,"marketing_page":false,"home_path":"/","login_path":"/login?return_to=https%3A%2F%2Fgithub.com%2FFrameworkComputer%2FExpansionCards%2Fblob%2Fmain%2FMechanical%2FOpenSCAD%2FExpansionCard.scad","signup_path":"/signup?ref_cta=Sign+up\u0026ref_loc=header+logged+out\u0026ref_page=%2F%3Cuser-name%3E%2F%3Crepo-name%3E%2Fblob%2Fshow\u0026source=header-repo\u0026source_repo=FrameworkComputer%2FExpansionCards","signup_enabled":true,"is_signup_controller":false,"show_search_and_nav":true,"hide_search":false,"private_mode_enabled":false,"should_use_dotcom_links":true,"auth_hydro_click":"{\"event_type\":\"authentication.click\",\"payload\":{\"location_in_page\":\"site header menu\",\"repository_id\":null,\"auth_type\":\"SIGN_UP\",\"originating_url\":\"https://github.com/FrameworkComputer/ExpansionCards/blob/main/Mechanical/OpenSCAD/ExpansionCard.scad\",\"user_id\":null}}","auth_hydro_click_hmac":"6e0c5e2fbb57e37b740c687c48184fb1d4bcc5c96d1b547fd13790c75b7bf57b","overlay":false,"fixed":false}}</script>
  <div data-target="react-partial.reactRoot"><div data-color-mode="dark" data-light-theme="light" data-dark-theme="dark"><header class="MarketingHeader-module__root__Tk7n3 HeaderMktg header-logged-out" role="banner" data-marketing-header="true" data-color-mode="dark" data-light-theme="light" data-dark-theme="dark" data-is-top="true"><h2 class="MarketingHeader-module__visuallyHidden__sqKsl">Navigation Menu</h2><button type="button" class="MarketingHeader-module__backdrop__sw4RU" aria-label="Close navigation menu"></button><div class="MarketingHeader-module__bar__mBSyE"><div class="MarketingHeader-module__topRow__yeury"><div class="MarketingHeader-module__toggleSlot__hDxbh"><button type="button" class="HeaderMenuToggle-module__toggle__i8EiC" aria-label="Toggle navigation" aria-expanded="false"><span class="HeaderMenuToggle-module__toggleBar__jVN0H"></span><span class="HeaderMenuToggle-module__toggleBar__jVN0H"></span><span class="HeaderMenuToggle-module__toggleBar__jVN0H"></span></button></div><a href="/" aria-label="Homepage" class="HeaderLogo-module__logo__UFyHI" data-analytics-event="{&quot;action&quot;:&quot;homepage&quot;,&quot;tag&quot;:&quot;link&quot;,&quot;context&quot;:&quot;logo&quot;,&quot;location&quot;:&quot;header&quot;,&quot;label&quot;:&quot;homepage_link_logo_header&quot;}"><svg data-component="Octicon" aria-hidden="true" focusable="false" class="octicon octicon-mark-github" viewBox="0 0 24 24" width="32" height="32" fill="currentColor" display="inline-block" overflow="visible" style="vertical-align:text-bottom"><path d="M10.226 17.284c-2.965-.36-5.054-2.493-5.054-5.256 0-1.123.404-2.336 1.078-3.144-.292-.741-.247-2.314.09-2.965.898-.112 2.111.36 2.83 1.01.853-.269 1.752-.404 2.853-.404 1.1 0 1.999.135 2.807.382.696-.629 1.932-1.1 2.83-.988.315.606.36 2.179.067 2.942.72.854 1.101 2 1.101 3.167 0 2.763-2.089 4.852-5.098 5.234.763.494 1.28 1.572 1.28 2.807v2.336c0 .674.561 1.056 1.235.786 4.066-1.55 7.255-5.615 7.255-10.646C23.5 6.188 18.334 1 11.978 1 5.62 1 .5 6.188.5 12.545c0 4.986 3.167 9.12 7.435 10.669.606.225 1.19-.18 1.19-.786V20.63a2.9 2.9 0 0 1-1.078.224c-1.483 0-2.359-.808-2.987-2.313-.247-.607-.517-.966-1.034-1.033-.27-.023-.359-.135-.359-.27 0-.27.45-.471.898-.471.652 0 1.213.404 1.797 1.235.45.651.921.943 1.483.943.561 0 .92-.202 1.437-.719.382-.381.674-.718.944-.943"></path></svg></a><div class="AuthCTAs-module__mobileActions__NNzeV"><a class="Primer_Brand__Button-module__Button___scH9Z Primer_Brand__Button-module__Button--subtle___F7pEE Primer_Brand__Button-module__Button--size-small___zQrEw AuthCTAs-module__cta__WpwQq" href="/login?return_to=https%3A%2F%2Fgithub.com%2FFrameworkComputer%2FExpansionCards%2Fblob%2Fmain%2FMechanical%2FOpenSCAD%2FExpansionCard.scad" data-analytics-event="{&quot;action&quot;:&quot;sign_in&quot;,&quot;tag&quot;:&quot;link&quot;,&quot;context&quot;:&quot;auth_cta&quot;,&quot;location&quot;:&quot;header&quot;,&quot;label&quot;:&quot;sign_in_link_auth_cta_header&quot;}" data-hydro-click="{&quot;event_type&quot;:&quot;authentication.click&quot;,&quot;payload&quot;:{&quot;location_in_page&quot;:&quot;site header menu&quot;,&quot;repository_id&quot;:null,&quot;auth_type&quot;:&quot;SIGN_UP&quot;,&quot;originating_url&quot;:&quot;https://github.com/FrameworkComputer/ExpansionCards/blob/main/Mechanical/OpenSCAD/ExpansionCard.scad&quot;,&quot;user_id&quot;:null}}" data-hydro-click-hmac="6e0c5e2fbb57e37b740c687c48184fb1d4bcc5c96d1b547fd13790c75b7bf57b"><span class="Primer_Brand__Button-module__Button__text___ED0bX"><span class="Primer_Brand__Text-module__Text___XeGJJ Primer_Brand__Text-module__Text-font--mona-sans___a8XJD Primer_Brand__Text-module__Text--default___GhPh_ Primer_Brand__Text-module__Text--100___B2ueX Primer_Brand__Text-module__Text--weight-medium___qJKf_ Primer_Brand__Button-module__Button--label___qrkyz Primer_Brand__Button-module__Button--label-subtle___8ndWH">Sign in</span></span></a><button class="Primer_Brand__Button-module__Button___scH9Z Primer_Brand__Button-module__Button--subtle___F7pEE Primer_Brand__Button-module__Button--size-small___zQrEw HeaderAppearanceSettings-module__trigger__hUheK" type="button" aria-haspopup="dialog" aria-labelledby="_R_3dd_"><span class="Primer_Brand__Button-module__Button__leading-visual___jjtTe" data-testid="Button-leading-visual"><svg data-component="Octicon" focusable="false" aria-hidden="true" class="octicon octicon-sliders Primer_Brand__Button-module__Button__icon-visual____qybb" viewBox="0 0 16 16" width="16" height="16" fill="currentColor" display="inline-block" overflow="visible" style="vertical-align:text-bottom"><path d="M15 2.75a.75.75 0 0 1-.75.75h-4a.75.75 0 0 1 0-1.5h4a.75.75 0 0 1 .75.75Zm-8.5.75v1.25a.75.75 0 0 0 1.5 0v-4a.75.75 0 0 0-1.5 0V2H1.75a.75.75 0 0 0 0 1.5H6.5Zm1.25 5.25a.75.75 0 0 0 0-1.5h-6a.75.75 0 0 0 0 1.5h6ZM15 8a.75.75 0 0 1-.75.75H11.5V10a.75.75 0 1 1-1.5 0V6a.75.75 0 0 1 1.5 0v1.25h2.75A.75.75 0 0 1 15 8Zm-9 5.25v-2a.75.75 0 0 0-1.5 0v1.25H1.75a.75.75 0 0 0 0 1.5H4.5v1.25a.75.75 0 0 0 1.5 0v-2Zm9 0a.75.75 0 0 1-.75.75h-6a.75.75 0 0 1 0-1.5h6a.75.75 0 0 1 .75.75Z"></path></svg></span><span class="Primer_Brand__Button-module__Button__text___ED0bX"><span class="Primer_Brand__Text-module__Text___XeGJJ Primer_Brand__Text-module__Text-font--mona-sans___a8XJD Primer_Brand__Text-module__Text--default___GhPh_ Primer_Brand__Text-module__Text--100___B2ueX Primer_Brand__Text-module__Text--weight-medium___qJKf_ Primer_Brand__Button-module__Button--label___qrkyz Primer_Brand__Button-module__Button--label-subtle___8ndWH"></span></span></button><div class="Primer_Brand__Tooltip-module__Tooltip___0Eipx" data-direction="s" aria-hidden="true" id="_R_3dd_">Appearance settings</div></div></div><div class="MarketingHeader-module__menu__GIy3y"><div class="MarketingHeader-module__menuWrapper__owstH"><nav class="MarketingNavigation-module__nav__W0KYY" aria-label="Global"><ul class="MarketingNavigation-module__list__tFbMb"><li><div class="NavDropdown-module__container__l2YeI"><button type="button" class="NavDropdown-module__button__PEHWX" aria-expanded="false" aria-controls="_R_nd_">Platform<svg data-component="Octicon" aria-hidden="true" focusable="false" class="octicon octicon-triangle-right NavDropdown-module__buttonIcon__Tkl8_" viewBox="0 0 16 16" width="16" height="16" fill="currentColor" display="inline-block" overflow="visible" style="vertical-align:text-bottom"><path d="m6.427 4.427 3.396 3.396a.25.25 0 0 1 0 .354l-3.396 3.396A.25.25 0 0 1 6 11.396V4.604a.25.25 0 0 1 .427-.177Z"></path></svg></button><div id="_R_nd_" class="NavDropdown-module__dropdown__xm1jd"><ul class="NavDropdown-module__list__zuCgG"><li><div class="NavGroup-module__group__W8SqJ"><span class="Primer_Brand__Text-module__Text___XeGJJ Primer_Brand__Text-module__Text-font--monospace___QXHDQ Primer_Brand__Text-module__Text--muted___rE6mh Primer_Brand__Text-module__Text--100___B2ueX Primer_Brand__Text-module__Text--weight-medium___qJKf_ NavGroup-module__title__Wzxz2" id="_R_5knd_">AI CODE CREATION</span><ul class="NavGroup-module__list__UCOFy" aria-labelledby="_R_5knd_"><li><a class="Primer_Brand__Link-module__Link___lF11y Primer_Brand__Link-module__Link--default___VRVW0 NavLink-module__link__EG3d4" href="https://github.com/features/copilot" data-analytics-event="{&quot;action&quot;:&quot;github_copilot&quot;,&quot;tag&quot;:&quot;link&quot;,&quot;context&quot;:&quot;platform&quot;,&quot;location&quot;:&quot;navbar&quot;,&quot;label&quot;:&quot;github_copilot_link_platform_navbar&quot;}"><span class="Primer_Brand__Text-module__Text___XeGJJ Primer_Brand__Text-module__Text-font--mona-sans___a8XJD Primer_Brand__Text-module__Text--default___GhPh_ Primer_Brand__Text-module__Text--200____P1wy Primer_Brand__Text-module__Text--antialiased___TYoXS Primer_Brand__Link-module__Link--label___jM8Ty"><span class="Primer_Brand__Text-module__Text___XeGJJ Primer_Brand__Text-module__Text-font--mona-sans___a8XJD Primer_Brand__Text-module__Text--default___GhPh_ Primer_Brand__Text-module__Text--200____P1wy Primer_Brand__Text-module__Text--antialiased___TYoXS Primer_Brand__Text-module__Text--weight-medium___qJKf_ NavLink-module__title__Q7t0p"><svg data-component="Octicon" aria-hidden="true" focusable="false" class="octicon octicon-copilot NavLink-module__icon__ltGNM" viewBox="0 0 16 16" width="16" height="16" fill="currentColor" display="inline-block" overflow="visible" style="vertical-align:text-bottom"><path d="M7.998 15.035c-4.562 0-7.873-2.914-7.998-3.749V9.338c.085-.628.677-1.686 1.588-2.065.013-.07.024-.143.036-.218.029-.183.06-.384.126-.612-.201-.508-.254-1.084-.254-1.656 0-.87.128-1.769.693-2.484.579-.733 1.494-1.124 2.724-1.261 1.206-.134 2.262.034 2.944.765.05.053.096.108.139.165.044-.057.094-.112.143-.165.682-.731 1.738-.899 2.944-.765 1.23.137 2.145.528 2.724 1.261.566.715.693 1.614.693 2.484 0 .572-.053 1.148-.254 1.656.066.228.098.429.126.612.012.076.024.148.037.218.924.385 1.522 1.471 1.591 2.095v1.872c0 .766-3.351 3.795-8.002 3.795Zm0-1.485c2.28 0 4.584-1.11 5.002-1.433V7.862l-.023-.116c-.49.21-1.075.291-1.727.291-1.146 0-2.059-.327-2.71-.991A3.222 3.222 0 0 1 8 6.303a3.24 3.24 0 0 1-.544.743c-.65.664-1.563.991-2.71.991-.652 0-1.236-.081-1.727-.291l-.023.116v4.255c.419.323 2.722 1.433 5.002 1.433ZM6.762 2.83c-.193-.206-.637-.413-1.682-.297-1.019.113-1.479.404-1.713.7-.247.312-.369.789-.369 1.554 0 .793.129 1.171.308 1.371.162.181.519.379 1.442.379.853 0 1.339-.235 1.638-.54.315-.322.527-.827.617-1.553.117-.935-.037-1.395-.241-1.614Zm4.155-.297c-1.044-.116-1.488.091-1.681.297-.204.219-.359.679-.242 1.614.091.726.303 1.231.618 1.553.299.305.784.54 1.638.54.922 0 1.28-.198 1.442-.379.179-.2.308-.578.308-1.371 0-.765-.123-1.242-.37-1.554-.233-.296-.693-.587-1.713-.7Z"></path><path d="M6.25 9.037a.75.75 0 0 1 .75.75v1.501a.75.75 0 0 1-1.5 0V9.787a.75.75 0 0 1 .75-.75Zm4.25.75v1.501a.75.75 0 0 1-1.5 0V9.787a.75.75 0 0 1 1.5 0Z"></path></svg>GitHub Copilot</span><span class="Primer_Brand__Text-module__Text___XeGJJ Primer_Brand__Text-module__Text-font--mona-sans___a8XJD Primer_Brand__Text-module__Text--muted___rE6mh Primer_Brand__Text-module__Text--200____P1wy Primer_Brand__Text-module__Text--antialiased___TYoXS NavLink-module__subtitle__X4gkW">Write better code with AI</span></span></a></li><li><a class="Primer_Brand__Link-module__Link___lF11y Primer_Brand__Link-module__Link--default___VRVW0 NavLink-module__link__EG3d4" href="https://github.com/features/ai/github-app" data-analytics-event="{&quot;action&quot;:&quot;github_copilot_app&quot;,&quot;tag&quot;:&quot;link&quot;,&quot;context&quot;:&quot;platform&quot;,&quot;location&quot;:&quot;navbar&quot;,&quot;label&quot;:&quot;github_copilot_app_link_platform_navbar&quot;}"><span class="Primer_Brand__Text-module__Text___XeGJJ Primer_Brand__Text-module__Text-font--mona-sans___a8XJD Primer_Brand__Text-module__Text--default___GhPh_ Primer_Brand__Text-module__Text--200____P1wy Primer_Brand__Text-module__Text--antialiased___TYoXS Primer_Brand__Link-module__Link--label___jM8Ty"><span class="Primer_Brand__Text-module__Text___XeGJJ Primer_Brand__Text-module__Text-font--mona-sans___a8XJD Primer_Brand__Text-module__Text--default___GhPh_ Primer_Brand__Text-module__Text--200____P1wy Primer_Brand__Text-module__Text--antialiased___TYoXS Primer_Brand__Text-module__Text--weight-medium___qJKf_ NavLink-module__title__Q7t0p"><svg data-component="Octicon" aria-hidden="true" focusable="false" class="octicon octicon-mark-github NavLink-module__icon__ltGNM" viewBox="0 0 16 16" width="16" height="16" fill="currentColor" display="inline-block" overflow="visible" style="vertical-align:text-bottom"><path d="M6.766 11.328c-2.063-.25-3.516-1.734-3.516-3.656 0-.781.281-1.625.75-2.188-.203-.515-.172-1.609.063-2.062.625-.078 1.468.25 1.968.703.594-.187 1.219-.281 1.985-.281.765 0 1.39.094 1.953.265.484-.437 1.344-.765 1.969-.687.218.422.25 1.515.046 2.047.5.593.766 1.39.766 2.203 0 1.922-1.453 3.375-3.547 3.64.531.344.89 1.094.89 1.954v1.625c0 .468.391.734.86.547C13.781 14.359 16 11.53 16 8.03 16 3.61 12.406 0 7.984 0 3.563 0 0 3.61 0 8.031a7.88 7.88 0 0 0 5.172 7.422c.422.156.828-.125.828-.547v-1.25c-.219.094-.5.156-.75.156-1.031 0-1.64-.562-2.078-1.609-.172-.422-.36-.672-.719-.719-.187-.015-.25-.093-.25-.187 0-.188.313-.328.625-.328.453 0 .844.281 1.25.86.313.452.64.655 1.031.655s.641-.14 1-.5c.266-.265.47-.5.657-.656"></path></svg>GitHub Copilot app</span><span class="Primer_Brand__Text-module__Text___XeGJJ Primer_Brand__Text-module__Text-font--mona-sans___a8XJD Primer_Brand__Text-module__Text--muted___rE6mh Primer_Brand__Text-module__Text--200____P1wy Primer_Brand__Text-module__Text--antialiased___TYoXS NavLink-module__subtitle__X4gkW">Direct agents from issue to merge</span></span></a></li><li><a class="Primer_Brand__Link-module__Link___lF11y Primer_Brand__Link-module__Link--default___VRVW0 NavLink-module__link__EG3d4" href="https://github.com/mcp" data-analytics-event="{&quot;action&quot;:&quot;mcp_registry&quot;,&quot;tag&quot;:&quot;link&quot;,&quot;context&quot;:&quot;platform&quot;,&quot;location&quot;:&quot;navbar&quot;,&quot;label&quot;:&quot;mcp_registry_link_platform_navbar&quot;}"><span class="Primer_Brand__Text-module__Text___XeGJJ Primer_Brand__Text-module__Text-font--mona-sans___a8XJD Primer_Brand__Text-module__Text--default___GhPh_ Primer_Brand__Text-module__Text--200____P1wy Primer_Brand__Text-module__Text--antialiased___TYoXS Primer_Brand__Link-module__Link--label___jM8Ty"><span class="Primer_Brand__Text-module__Text___XeGJJ Primer_Brand__Text-module__Text-font--mona-sans___a8XJD Primer_Brand__Text-module__Text--default___GhPh_ Primer_Brand__Text-module__Text--200____P1wy Primer_Brand__Text-module__Text--antialiased___TYoXS Primer_Brand__Text-module__Text--weight-medium___qJKf_ NavLink-module__title__Q7t0p"><svg data-component="Octicon" aria-hidden="true" focusable="false" class="octicon octicon-mcp NavLink-module__icon__ltGNM" viewBox="0 0 16 16" width="16" height="16" fill="currentColor" display="inline-block" overflow="visible" style="vertical-align:text-bottom"><path d="M5.52 1.12a3.578 3.578 0 0 1 6.078 2.98 3.578 3.578 0 0 1 2.982 6.08l-3.292 3.293a.252.252 0 0 0 0 .354l.843.843a.749.749 0 1 1-1.06 1.06l-.844-.843a1.75 1.75 0 0 1 0-2.474L13.52 9.12a2.08 2.08 0 0 0 0-2.94 2.08 2.08 0 0 0-2.94 0L7.731 9.03A.75.75 0 0 1 6.67 7.97l2.85-2.85a2.08 2.08 0 0 0 0-2.94 2.08 2.08 0 0 0-2.94 0l-4.799 4.8A.75.75 0 0 1 .72 5.92Z"></path><path d="M7.52 3.12a.749.749 0 1 1 1.06 1.06L5.731 7.03A2.079 2.079 0 0 0 8.67 9.97l2.85-2.85a.749.749 0 1 1 1.06 1.06l-2.849 2.85A3.578 3.578 0 0 1 4.67 5.97Z"></path></svg>MCP Registry</span><span class="Primer_Brand__Text-module__Text___XeGJJ Primer_Brand__Text-module__Text-font--mona-sans___a8XJD Primer_Brand__Text-module__Text--muted___rE6mh Primer_Brand__Text-module__Text--200____P1wy Primer_Brand__Text-module__Text--antialiased___TYoXS NavLink-module__subtitle__X4gkW">Integrate external tools</span></span></a></li></ul></div></li><li><div class="NavGroup-module__group__W8SqJ"><span class="Primer_Brand__Text-module__Text___XeGJJ Primer_Brand__Text-module__Text-font--monospace___QXHDQ Primer_Brand__Text-module__Text--muted___rE6mh Primer_Brand__Text-module__Text--100___B2ueX Primer_Brand__Text-module__Text--weight-medium___qJKf_ NavGroup-module__title__Wzxz2" id="_R_9knd_">DEVELOPER WORKFLOWS</span><ul class="NavGroup-module__list__UCOFy" aria-labelledby="_R_9knd_"><li><a class="Primer_Brand__Link-module__Link___lF11y Primer_Brand__Link-module__Link--default___VRVW0 NavLink-module__link__EG3d4" href="https://github.com/features/actions" data-analytics-event="{&quot;action&quot;:&quot;actions&quot;,&quot;tag&quot;:&quot;link&quot;,&quot;context&quot;:&quot;platform&quot;,&quot;location&quot;:&quot;navbar&quot;,&quot;label&quot;:&quot;actions_link_platform_navbar&quot;}"><span class="Primer_Brand__Text-module__Text___XeGJJ Primer_Brand__Text-module__Text-font--mona-sans___a8XJD Primer_Brand__Text-module__Text--default___GhPh_ Primer_Brand__Text-module__Text--200____P1wy Primer_Brand__Text-module__Text--antialiased___TYoXS Primer_Brand__Link-module__Link--label___jM8Ty"><span class="Primer_Brand__Text-module__Text___XeGJJ Primer_Brand__Text-module__Text-font--mona-sans___a8XJD Primer_Brand__Text-module__Text--default___GhPh_ Primer_Brand__Text-module__Text--200____P1wy Primer_Brand__Text-module__Text--antialiased___TYoXS Primer_Brand__Text-module__Text--weight-medium___qJKf_ NavLink-module__title__Q7t0p"><svg data-component="Octicon" aria-hidden="true" focusable="false" class="octicon octicon-workflow NavLink-module__icon__ltGNM" viewBox="0 0 16 16" width="16" height="16" fill="currentColor" display="inline-block" overflow="visible" style="vertical-align:text-bottom"><path d="M0 1.75C0 .784.784 0 1.75 0h3.5C6.216 0 7 .784 7 1.75v3.5A1.75 1.75 0 0 1 5.25 7H4v4a1 1 0 0 0 1 1h4v-1.25C9 9.784 9.784 9 10.75 9h3.5c.966 0 1.75.784 1.75 1.75v3.5A1.75 1.75 0 0 1 14.25 16h-3.5A1.75 1.75 0 0 1 9 14.25v-.75H5A2.5 2.5 0 0 1 2.5 11V7h-.75A1.75 1.75 0 0 1 0 5.25Zm1.75-.25a.25.25 0 0 0-.25.25v3.5c0 .138.112.25.25.25h3.5a.25.25 0 0 0 .25-.25v-3.5a.25.25 0 0 0-.25-.25Zm9 9a.25.25 0 0 0-.25.25v3.5c0 .138.112.25.25.25h3.5a.25.25 0 0 0 .25-.25v-3.5a.25.25 0 0 0-.25-.25Z"></path></svg>Actions</span><span class="Primer_Brand__Text-module__Text___XeGJJ Primer_Brand__Text-module__Text-font--mona-sans___a8XJD Primer_Brand__Text-module__Text--muted___rE6mh Primer_Brand__Text-module__Text--200____P1wy Primer_Brand__Text-module__Text--antialiased___TYoXS NavLink-module__subtitle__X4gkW">Automate any workflow</span></span></a></li><li><a class="Primer_Brand__Link-module__Link___lF11y Primer_Brand__Link-module__Link--default___VRVW0 NavLink-module__link__EG3d4" href="https://github.com/features/codespaces" data-analytics-event="{&quot;action&quot;:&quot;codespaces&quot;,&quot;tag&quot;:&quot;link&quot;,&quot;context&quot;:&quot;platform&quot;,&quot;location&quot;:&quot;navbar&quot;,&quot;label&quot;:&quot;codespaces_link_platform_navbar&quot;}"><span class="Primer_Brand__Text-module__Text___XeGJJ Primer_Brand__Text-module__Text-font--mona-sans___a8XJD Primer_Brand__Text-module__Text--default___GhPh_ Primer_Brand__Text-module__Text--200____P1wy Primer_Brand__Text-module__Text--antialiased___TYoXS Primer_Brand__Link-module__Link--label___jM8Ty"><span class="Primer_Brand__Text-module__Text___XeGJJ Primer_Brand__Text-module__Text-font--mona-sans___a8XJD Primer_Brand__Text-module__Text--default___GhPh_ Primer_Brand__Text-module__Text--200____P1wy Primer_Brand__Text-module__Text--antialiased___TYoXS Primer_Brand__Text-module__Text--weight-medium___qJKf_ NavLink-module__title__Q7t0p"><svg data-component="Octicon" aria-hidden="true" focusable="false" class="octicon octicon-codespaces NavLink-module__icon__ltGNM" viewBox="0 0 16 16" width="16" height="16" fill="currentColor" display="inline-block" overflow="visible" style="vertical-align:text-bottom"><path d="M0 11.25c0-.966.784-1.75 1.75-1.75h12.5c.966 0 1.75.784 1.75 1.75v3A1.75 1.75 0 0 1 14.25 16H1.75A1.75 1.75 0 0 1 0 14.25Zm2-9.5C2 .784 2.784 0 3.75 0h8.5C13.216 0 14 .784 14 1.75v5a1.75 1.75 0 0 1-1.75 1.75h-8.5A1.75 1.75 0 0 1 2 6.75Zm1.75-.25a.25.25 0 0 0-.25.25v5c0 .138.112.25.25.25h8.5a.25.25 0 0 0 .25-.25v-5a.25.25 0 0 0-.25-.25Zm-2 9.5a.25.25 0 0 0-.25.25v3c0 .138.112.25.25.25h12.5a.25.25 0 0 0 .25-.25v-3a.25.25 0 0 0-.25-.25Z"></path><path d="M7 12.75a.75.75 0 0 1 .75-.75h4.5a.75.75 0 0 1 0 1.5h-4.5a.75.75 0 0 1-.75-.75Zm-4 0a.75.75 0 0 1 .75-.75h.5a.75.75 0 0 1 0 1.5h-.5a.75.75 0 0 1-.75-.75Z"></path></svg>Codespaces</span><span class="Primer_Brand__Text-module__Text___XeGJJ Primer_Brand__Text-module__Text-font--mona-sans___a8XJD Primer_Brand__Text-module__Text--muted___rE6mh Primer_Brand__Text-module__Text--200____P1wy Primer_Brand__Text-module__Text--antialiased___TYoXS NavLink-module__subtitle__X4gkW">Instant dev environments</span></span></a></li><li><a class="Primer_Brand__Link-module__Link___lF11y Primer_Brand__Link-module__Link--default___VRVW0 NavLink-module__link__EG3d4" href="https://github.com/features/issues" data-analytics-event="{&quot;action&quot;:&quot;issues&quot;,&quot;tag&quot;:&quot;link&quot;,&quot;context&quot;:&quot;platform&quot;,&quot;location&quot;:&quot;navbar&quot;,&quot;label&quot;:&quot;issues_link_platform_navbar&quot;}"><span class="Primer_Brand__Text-module__Text___XeGJJ Primer_Brand__Text-module__Text-font--mona-sans___a8XJD Primer_Brand__Text-module__Text--default___GhPh_ Primer_Brand__Text-module__Text--200____P1wy Primer_Brand__Text-module__Text--antialiased___TYoXS Primer_Brand__Link-module__Link--label___jM8Ty"><span class="Primer_Brand__Text-module__Text___XeGJJ Primer_Brand__Text-module__Text-font--mona-sans___a8XJD Primer_Brand__Text-module__Text--default___GhPh_ Primer_Brand__Text-module__Text--200____P1wy Primer_Brand__Text-module__Text--antialiased___TYoXS Primer_Brand__Text-module__Text--weight-medium___qJKf_ NavLink-module__title__Q7t0p"><svg data-component="Octicon" aria-hidden="true" focusable="false" class="octicon octicon-issue-opened NavLink-module__icon__ltGNM" viewBox="0 0 16 16" width="16" height="16" fill="currentColor" display="inline-block" overflow="visible" style="vertical-align:text-bottom"><path d="M8 9.5a1.5 1.5 0 1 0 0-3 1.5 1.5 0 0 0 0 3Z"></path><path d="M8 0a8 8 0 1 1 0 16A8 8 0 0 1 8 0ZM1.5 8a6.5 6.5 0 1 0 13 0 6.5 6.5 0 0 0-13 0Z"></path></svg>Issues</span><span class="Primer_Brand__Text-module__Text___XeGJJ Primer_Brand__Text-module__Text-font--mona-sans___a8XJD Primer_Brand__Text-module__Text--muted___rE6mh Primer_Brand__Text-module__Text--200____P1wy Primer_Brand__Text-module__Text--antialiased___TYoXS NavLink-module__subtitle__X4gkW">Plan and track work</span></span></a></li><li><a class="Primer_Brand__Link-module__Link___lF11y Primer_Brand__Link-module__Link--default___VRVW0 NavLink-module__link__EG3d4" href="https://github.com/features/code-review" data-analytics-event="{&quot;action&quot;:&quot;code_review&quot;,&quot;tag&quot;:&quot;link&quot;,&quot;context&quot;:&quot;platform&quot;,&quot;location&quot;:&quot;navbar&quot;,&quot;label&quot;:&quot;code_review_link_platform_navbar&quot;}"><span class="Primer_Brand__Text-module__Text___XeGJJ Primer_Brand__Text-module__Text-font--mona-sans___a8XJD Primer_Brand__Text-module__Text--default___GhPh_ Primer_Brand__Text-module__Text--200____P1wy Primer_Brand__Text-module__Text--antialiased___TYoXS Primer_Brand__Link-module__Link--label___jM8Ty"><span class="Primer_Brand__Text-module__Text___XeGJJ Primer_Brand__Text-module__Text-font--mona-sans___a8XJD Primer_Brand__Text-module__Text--default___GhPh_ Primer_Brand__Text-module__Text--200____P1wy Primer_Brand__Text-module__Text--antialiased___TYoXS Primer_Brand__Text-module__Text--weight-medium___qJKf_ NavLink-module__title__Q7t0p"><svg data-component="Octicon" aria-hidden="true" focusable="false" class="octicon octicon-code NavLink-module__icon__ltGNM" viewBox="0 0 16 16" width="16" height="16" fill="currentColor" display="inline-block" overflow="visible" style="vertical-align:text-bottom"><path d="m11.28 3.22 4.25 4.25a.75.75 0 0 1 0 1.06l-4.25 4.25a.749.749 0 0 1-1.275-.326.749.749 0 0 1 .215-.734L13.94 8l-3.72-3.72a.749.749 0 0 1 .326-1.275.749.749 0 0 1 .734.215Zm-6.56 0a.751.751 0 0 1 1.042.018.751.751 0 0 1 .018 1.042L2.06 8l3.72 3.72a.749.749 0 0 1-.326 1.275.749.749 0 0 1-.734-.215L.47 8.53a.75.75 0 0 1 0-1.06Z"></path></svg>Code Review</span><span class="Primer_Brand__Text-module__Text___XeGJJ Primer_Brand__Text-module__Text-font--mona-sans___a8XJD Primer_Brand__Text-module__Text--muted___rE6mh Primer_Brand__Text-module__Text--200____P1wy Primer_Brand__Text-module__Text--antialiased___TYoXS NavLink-module__subtitle__X4gkW">Manage code changes</span></span></a></li><li><a class="Primer_Brand__Link-module__Link___lF11y Primer_Brand__Link-module__Link--default___VRVW0 NavLink-module__link__EG3d4" href="https://github.com/features/code-quality" data-analytics-event="{&quot;action&quot;:&quot;code_quality&quot;,&quot;tag&quot;:&quot;link&quot;,&quot;context&quot;:&quot;platform&quot;,&quot;location&quot;:&quot;navbar&quot;,&quot;label&quot;:&quot;code_quality_link_platform_navbar&quot;}"><span class="Primer_Brand__Text-module__Text___XeGJJ Primer_Brand__Text-module__Text-font--mona-sans___a8XJD Primer_Brand__Text-module__Text--default___GhPh_ Primer_Brand__Text-module__Text--200____P1wy Primer_Brand__Text-module__Text--antialiased___TYoXS Primer_Brand__Link-module__Link--label___jM8Ty"><span class="Primer_Brand__Text-module__Text___XeGJJ Primer_Brand__Text-module__Text-font--mona-sans___a8XJD Primer_Brand__Text-module__Text--default___GhPh_ Primer_Brand__Text-module__Text--200____P1wy Primer_Brand__Text-module__Text--antialiased___TYoXS Primer_Brand__Text-module__Text--weight-medium___qJKf_ NavLink-module__title__Q7t0p"><svg data-component="Octicon" aria-hidden="true" focusable="false" class="octicon octicon-codescan-checkmark NavLink-module__icon__ltGNM" viewBox="0 0 16 16" width="16" height="16" fill="currentColor" display="inline-block" overflow="visible" style="vertical-align:text-bottom"><path d="M10.28 6.28a.75.75 0 1 0-1.06-1.06L6.25 8.19l-.97-.97a.75.75 0 0 0-1.06 1.06l1.5 1.5a.75.75 0 0 0 1.06 0l3.5-3.5Z"></path><path d="M7.5 15a7.5 7.5 0 1 1 5.807-2.754l2.473 2.474a.749.749 0 0 1-.326 1.275.749.749 0 0 1-.734-.215l-2.474-2.473A7.472 7.472 0 0 1 7.5 15Zm0-13.5a6 6 0 1 0 4.094 10.386.748.748 0 0 1 .293-.292 6.002 6.002 0 0 0 1.117-6.486A6.002 6.002 0 0 0 7.5 1.5Z"></path></svg>Code Quality</span><span class="Primer_Brand__Text-module__Text___XeGJJ Primer_Brand__Text-module__Text-font--mona-sans___a8XJD Primer_Brand__Text-module__Text--muted___rE6mh Primer_Brand__Text-module__Text--200____P1wy Primer_Brand__Text-module__Text--antialiased___TYoXS NavLink-module__subtitle__X4gkW">Enforce quality at merge</span></span></a></li></ul></div></li><li><div class="NavGroup-module__group__W8SqJ"><span class="Primer_Brand__Text-module__Text___XeGJJ Primer_Brand__Text-module__Text-font--monospace___QXHDQ Primer_Brand__Text-module__Text--muted___rE6mh Primer_Brand__Text-module__Text--100___B2ueX Primer_Brand__Text-module__Text--weight-medium___qJKf_ NavGroup-module__title__Wzxz2" id="_R_dknd_">APPLICATION SECURITY</span><ul class="NavGroup-module__list__UCOFy" aria-labelledby="_R_dknd_"><li><a class="Primer_Brand__Link-module__Link___lF11y Primer_Brand__Link-module__Link--default___VRVW0 NavLink-module__link__EG3d4" href="https://github.com/security/advanced-security" data-analytics-event="{&quot;action&quot;:&quot;github_advanced_security&quot;,&quot;tag&quot;:&quot;link&quot;,&quot;context&quot;:&quot;platform&quot;,&quot;location&quot;:&quot;navbar&quot;,&quot;label&quot;:&quot;github_advanced_security_link_platform_navbar&quot;}"><span class="Primer_Brand__Text-module__Text___XeGJJ Primer_Brand__Text-module__Text-font--mona-sans___a8XJD Primer_Brand__Text-module__Text--default___GhPh_ Primer_Brand__Text-module__Text--200____P1wy Primer_Brand__Text-module__Text--antialiased___TYoXS Primer_Brand__Link-module__Link--label___jM8Ty"><span class="Primer_Brand__Text-module__Text___XeGJJ Primer_Brand__Text-module__Text-font--mona-sans___a8XJD Primer_Brand__Text-module__Text--default___GhPh_ Primer_Brand__Text-module__Text--200____P1wy Primer_Brand__Text-module__Text--antialiased___TYoXS Primer_Brand__Text-module__Text--weight-medium___qJKf_ NavLink-module__title__Q7t0p"><svg data-component="Octicon" aria-hidden="true" focusable="false" class="octicon octicon-shield-check NavLink-module__icon__ltGNM" viewBox="0 0 16 16" width="16" height="16" fill="currentColor" display="inline-block" overflow="visible" style="vertical-align:text-bottom"><path d="m8.533.133 5.25 1.68A1.75 1.75 0 0 1 15 3.48V7c0 1.566-.32 3.182-1.303 4.682-.983 1.498-2.585 2.813-5.032 3.855a1.697 1.697 0 0 1-1.33 0c-2.447-1.042-4.049-2.357-5.032-3.855C1.32 10.182 1 8.566 1 7V3.48a1.75 1.75 0 0 1 1.217-1.667l5.25-1.68a1.748 1.748 0 0 1 1.066 0Zm-.61 1.429.001.001-5.25 1.68a.251.251 0 0 0-.174.237V7c0 1.36.275 2.666 1.057 3.859.784 1.194 2.121 2.342 4.366 3.298a.196.196 0 0 0 .154 0c2.245-.957 3.582-2.103 4.366-3.297C13.225 9.666 13.5 8.358 13.5 7V3.48a.25.25 0 0 0-.174-.238l-5.25-1.68a.25.25 0 0 0-.153 0ZM11.28 6.28l-3.5 3.5a.75.75 0 0 1-1.06 0l-1.5-1.5a.749.749 0 0 1 .326-1.275.749.749 0 0 1 .734.215l.97.97 2.97-2.97a.751.751 0 0 1 1.042.018.751.751 0 0 1 .018 1.042Z"></path></svg>GitHub Advanced Security</span><span class="Primer_Brand__Text-module__Text___XeGJJ Primer_Brand__Text-module__Text-font--mona-sans___a8XJD Primer_Brand__Text-module__Text--muted___rE6mh Primer_Brand__Text-module__Text--200____P1wy Primer_Brand__Text-module__Text--antialiased___TYoXS NavLink-module__subtitle__X4gkW">Find and fix vulnerabilities</span></span></a></li><li><a class="Primer_Brand__Link-module__Link___lF11y Primer_Brand__Link-module__Link--default___VRVW0 NavLink-module__link__EG3d4" href="https://github.com/security/advanced-security/code-security" data-analytics-event="{&quot;action&quot;:&quot;code_security&quot;,&quot;tag&quot;:&quot;link&quot;,&quot;context&quot;:&quot;platform&quot;,&quot;location&quot;:&quot;navbar&quot;,&quot;label&quot;:&quot;code_security_link_platform_navbar&quot;}"><span class="Primer_Brand__Text-module__Text___XeGJJ Primer_Brand__Text-module__Text-font--mona-sans___a8XJD Primer_Brand__Text-module__Text--default___GhPh_ Primer_Brand__Text-module__Text--200____P1wy Primer_Brand__Text-module__Text--antialiased___TYoXS Primer_Brand__Link-module__Link--label___jM8Ty"><span class="Primer_Brand__Text-module__Text___XeGJJ Primer_Brand__Text-module__Text-font--mona-sans___a8XJD Primer_Brand__Text-module__Text--default___GhPh_ Primer_Brand__Text-module__Text--200____P1wy Primer_Brand__Text-module__Text--antialiased___TYoXS Primer_Brand__Text-module__Text--weight-medium___qJKf_ NavLink-module__title__Q7t0p"><svg data-component="Octicon" aria-hidden="true" focusable="false" class="octicon octicon-code-square NavLink-module__icon__ltGNM" viewBox="0 0 16 16" width="16" height="16" fill="currentColor" display="inline-block" overflow="visible" style="vertical-align:text-bottom"><path d="M0 1.75C0 .784.784 0 1.75 0h12.5C15.216 0 16 .784 16 1.75v12.5A1.75 1.75 0 0 1 14.25 16H1.75A1.75 1.75 0 0 1 0 14.25Zm1.75-.25a.25.25 0 0 0-.25.25v12.5c0 .138.112.25.25.25h12.5a.25.25 0 0 0 .25-.25V1.75a.25.25 0 0 0-.25-.25Zm7.47 3.97a.75.75 0 0 1 1.06 0l2 2a.75.75 0 0 1 0 1.06l-2 2a.749.749 0 0 1-1.275-.326.749.749 0 0 1 .215-.734L10.69 8 9.22 6.53a.75.75 0 0 1 0-1.06ZM6.78 6.53 5.31 8l1.47 1.47a.749.749 0 0 1-.326 1.275.749.749 0 0 1-.734-.215l-2-2a.75.75 0 0 1 0-1.06l2-2a.751.751 0 0 1 1.042.018.751.751 0 0 1 .018 1.042Z"></path></svg>Code security</span><span class="Primer_Brand__Text-module__Text___XeGJJ Primer_Brand__Text-module__Text-font--mona-sans___a8XJD Primer_Brand__Text-module__Text--muted___rE6mh Primer_Brand__Text-module__Text--200____P1wy Primer_Brand__Text-module__Text--antialiased___TYoXS NavLink-module__subtitle__X4gkW">Secure your code as you build</span></span></a></li><li><a class="Primer_Brand__Link-module__Link___lF11y Primer_Brand__Link-module__Link--default___VRVW0 NavLink-module__link__EG3d4" href="https://github.com/security/advanced-security/secret-protection" data-analytics-event="{&quot;action&quot;:&quot;secret_protection&quot;,&quot;tag&quot;:&quot;link&quot;,&quot;context&quot;:&quot;platform&quot;,&quot;location&quot;:&quot;navbar&quot;,&quot;label&quot;:&quot;secret_protection_link_platform_navbar&quot;}"><span class="Primer_Brand__Text-module__Text___XeGJJ Primer_Brand__Text-module__Text-font--mona-sans___a8XJD Primer_Brand__Text-module__Text--default___GhPh_ Primer_Brand__Text-module__Text--200____P1wy Primer_Brand__Text-module__Text--antialiased___TYoXS Primer_Brand__Link-module__Link--label___jM8Ty"><span class="Primer_Brand__Text-module__Text___XeGJJ Primer_Brand__Text-module__Text-font--mona-sans___a8XJD Primer_Brand__Text-module__Text--default___GhPh_ Primer_Brand__Text-module__Text--200____P1wy Primer_Brand__Text-module__Text--antialiased___TYoXS Primer_Brand__Text-module__Text--weight-medium___qJKf_ NavLink-module__title__Q7t0p"><svg data-component="Octicon" aria-hidden="true" focusable="false" class="octicon octicon-lock NavLink-module__icon__ltGNM" viewBox="0 0 16 16" width="16" height="16" fill="currentColor" display="inline-block" overflow="visible" style="vertical-align:text-bottom"><path d="M4 4a4 4 0 0 1 8 0v2h.25c.966 0 1.75.784 1.75 1.75v5.5A1.75 1.75 0 0 1 12.25 15h-8.5A1.75 1.75 0 0 1 2 13.25v-5.5C2 6.784 2.784 6 3.75 6H4Zm8.25 3.5h-8.5a.25.25 0 0 0-.25.25v5.5c0 .138.112.25.25.25h8.5a.25.25 0 0 0 .25-.25v-5.5a.25.25 0 0 0-.25-.25ZM10.5 6V4a2.5 2.5 0 1 0-5 0v2Z"></path></svg>Secret protection</span><span class="Primer_Brand__Text-module__Text___XeGJJ Primer_Brand__Text-module__Text-font--mona-sans___a8XJD Primer_Brand__Text-module__Text--muted___rE6mh Primer_Brand__Text-module__Text--200____P1wy Primer_Brand__Text-module__Text--antialiased___TYoXS NavLink-module__subtitle__X4gkW">Stop leaks before they start</span></span></a></li></ul></div></li><li><div class="NavGroup-module__group__W8SqJ NavGroup-module__hasSeparator__FnMrN"><span class="Primer_Brand__Text-module__Text___XeGJJ Primer_Brand__Text-module__Text-font--monospace___QXHDQ Primer_Brand__Text-module__Text--muted___rE6mh Primer_Brand__Text-module__Text--100___B2ueX Primer_Brand__Text-module__Text--weight-medium___qJKf_ NavGroup-module__title__Wzxz2" id="_R_hknd_">EXPLORE</span><ul class="NavGroup-module__list__UCOFy" aria-labelledby="_R_hknd_"><li><a class="Primer_Brand__Link-module__Link___lF11y Primer_Brand__Link-module__Link--default___VRVW0" href="https://github.com/why-github" data-analytics-event="{&quot;action&quot;:&quot;why_github&quot;,&quot;tag&quot;:&quot;link&quot;,&quot;context&quot;:&quot;platform&quot;,&quot;location&quot;:&quot;navbar&quot;,&quot;label&quot;:&quot;why_github_link_platform_navbar&quot;}"><span class="Primer_Brand__Text-module__Text___XeGJJ Primer_Brand__Text-module__Text-font--mona-sans___a8XJD Primer_Brand__Text-module__Text--default___GhPh_ Primer_Brand__Text-module__Text--200____P1wy Primer_Brand__Text-module__Text--antialiased___TYoXS Primer_Brand__Link-module__Link--label___jM8Ty">Why GitHub</span></a></li><li><a class="Primer_Brand__Link-module__Link___lF11y Primer_Brand__Link-module__Link--default___VRVW0 Primer_Brand__Link-module__Link--is-external___xsncV" href="https://docs.github.com" data-analytics-event="{&quot;action&quot;:&quot;documentation&quot;,&quot;tag&quot;:&quot;link&quot;,&quot;context&quot;:&quot;platform&quot;,&quot;location&quot;:&quot;navbar&quot;,&quot;label&quot;:&quot;documentation_link_platform_navbar&quot;}" target="_blank" rel="noreferrer"><span class="Primer_Brand__Text-module__Text___XeGJJ Primer_Brand__Text-module__Text-font--mona-sans___a8XJD Primer_Brand__Text-module__Text--default___GhPh_ Primer_Brand__Text-module__Text--200____P1wy Primer_Brand__Text-module__Text--antialiased___TYoXS Primer_Brand__Link-module__Link--label___jM8Ty">Documentation</span><svg data-component="Octicon" focusable="false" aria-label="External link" class="octicon octicon-link-external" role="img" viewBox="0 0 16 16" width="16" height="16" fill="currentColor" display="inline-block" overflow="visible" style="vertical-align:text-bottom"><path d="M3.75 2h3.5a.75.75 0 0 1 0 1.5h-3.5a.25.25 0 0 0-.25.25v8.5c0 .138.112.25.25.25h8.5a.25.25 0 0 0 .25-.25v-3.5a.75.75 0 0 1 1.5 0v3.5A1.75 1.75 0 0 1 12.25 14h-8.5A1.75 1.75 0 0 1 2 12.25v-8.5C2 2.784 2.784 2 3.75 2Zm6.854-1h4.146a.25.25 0 0 1 .25.25v4.146a.25.25 0 0 1-.427.177L13.03 4.03 9.28 7.78a.751.751 0 0 1-1.042-.018.751.751 0 0 1-.018-1.042l3.75-3.75-1.543-1.543A.25.25 0 0 1 10.604 1Z"></path></svg></a></li><li><a class="Primer_Brand__Link-module__Link___lF11y Primer_Brand__Link-module__Link--default___VRVW0 Primer_Brand__Link-module__Link--is-external___xsncV" href="https://github.blog" data-analytics-event="{&quot;action&quot;:&quot;blog&quot;,&quot;tag&quot;:&quot;link&quot;,&quot;context&quot;:&quot;platform&quot;,&quot;location&quot;:&quot;navbar&quot;,&quot;label&quot;:&quot;blog_link_platform_navbar&quot;}" target="_blank" rel="noreferrer"><span class="Primer_Brand__Text-module__Text___XeGJJ Primer_Brand__Text-module__Text-font--mona-sans___a8XJD Primer_Brand__Text-module__Text--default___GhPh_ Primer_Brand__Text-module__Text--200____P1wy Primer_Brand__Text-module__Text--antialiased___TYoXS Primer_Brand__Link-module__Link--label___jM8Ty">Blog</span><svg data-component="Octicon" focusable="false" aria-label="External link" class="octicon octicon-link-external" role="img" viewBox="0 0 16 16" width="16" height="16" fill="currentColor" display="inline-block" overflow="visible" style="vertical-align:text-bottom"><path d="M3.75 2h3.5a.75.75 0 0 1 0 1.5h-3.5a.25.25 0 0 0-.25.25v8.5c0 .138.112.25.25.25h8.5a.25.25 0 0 0 .25-.25v-3.5a.75.75 0 0 1 1.5 0v3.5A1.75 1.75 0 0 1 12.25 14h-8.5A1.75 1.75 0 0 1 2 12.25v-8.5C2 2.784 2.784 2 3.75 2Zm6.854-1h4.146a.25.25 0 0 1 .25.25v4.146a.25.25 0 0 1-.427.177L13.03 4.03 9.28 7.78a.751.751 0 0 1-1.042-.018.751.751 0 0 1-.018-1.042l3.75-3.75-1.543-1.543A.25.25 0 0 1 10.604 1Z"></path></svg></a></li><li><a class="Primer_Brand__Link-module__Link___lF11y Primer_Brand__Link-module__Link--default___VRVW0 Primer_Brand__Link-module__Link--is-external___xsncV" href="https://github.blog/changelog" data-analytics-event="{&quot;action&quot;:&quot;changelog&quot;,&quot;tag&quot;:&quot;link&quot;,&quot;context&quot;:&quot;platform&quot;,&quot;location&quot;:&quot;navbar&quot;,&quot;label&quot;:&quot;changelog_link_platform_navbar&quot;}" target="_blank" rel="noreferrer"><span class="Primer_Brand__Text-module__Text___XeGJJ Primer_Brand__Text-module__Text-font--mona-sans___a8XJD Primer_Brand__Text-module__Text--default___GhPh_ Primer_Brand__Text-module__Text--200____P1wy Primer_Brand__Text-module__Text--antialiased___TYoXS Primer_Brand__Link-module__Link--label___jM8Ty">Changelog</span><svg data-component="Octicon" focusable="false" aria-label="External link" class="octicon octicon-link-external" role="img" viewBox="0 0 16 16" width="16" height="16" fill="currentColor" display="inline-block" overflow="visible" style="vertical-align:text-bottom"><path d="M3.75 2h3.5a.75.75 0 0 1 0 1.5h-3.5a.25.25 0 0 0-.25.25v8.5c0 .138.112.25.25.25h8.5a.25.25 0 0 0 .25-.25v-3.5a.75.75 0 0 1 1.5 0v3.5A1.75 1.75 0 0 1 12.25 14h-8.5A1.75 1.75 0 0 1 2 12.25v-8.5C2 2.784 2.784 2 3.75 2Zm6.854-1h4.146a.25.25 0 0 1 .25.25v4.146a.25.25 0 0 1-.427.177L13.03 4.03 9.28 7.78a.751.751 0 0 1-1.042-.018.751.751 0 0 1-.018-1.042l3.75-3.75-1.543-1.543A.25.25 0 0 1 10.604 1Z"></path></svg></a></li><li><a class="Primer_Brand__Link-module__Link___lF11y Primer_Brand__Link-module__Link--default___VRVW0" href="https://github.com/marketplace" data-analytics-event="{&quot;action&quot;:&quot;marketplace&quot;,&quot;tag&quot;:&quot;link&quot;,&quot;context&quot;:&quot;platform&quot;,&quot;location&quot;:&quot;navbar&quot;,&quot;label&quot;:&quot;marketplace_link_platform_navbar&quot;}"><span class="Primer_Brand__Text-module__Text___XeGJJ Primer_Brand__Text-module__Text-font--mona-sans___a8XJD Primer_Brand__Text-module__Text--default___GhPh_ Primer_Brand__Text-module__Text--200____P1wy Primer_Brand__Text-module__Text--antialiased___TYoXS Primer_Brand__Link-module__Link--label___jM8Ty">Marketplace</span></a></li></ul></div></li></ul><div class="NavDropdown-module__trailingLinkContainer__VgJGL"><a class="Primer_Brand__Link-module__Link___lF11y Primer_Brand__Link-module__Link--default___VRVW0 Primer_Brand__Link-module__Link--arrow-end___esdN8" href="https://github.com/features" data-analytics-event="{&quot;action&quot;:&quot;view_all_features&quot;,&quot;tag&quot;:&quot;link&quot;,&quot;context&quot;:&quot;platform&quot;,&quot;location&quot;:&quot;navbar&quot;,&quot;label&quot;:&quot;view_all_features_link_platform_navbar&quot;}"><span class="Primer_Brand__Text-module__Text___XeGJJ Primer_Brand__Text-module__Text-font--mona-sans___a8XJD Primer_Brand__Text-module__Text--default___GhPh_ Primer_Brand__Text-module__Text--200____P1wy Primer_Brand__Text-module__Text--antialiased___TYoXS Primer_Brand__Link-module__Link--label___jM8Ty">View all features</span><svg class="Primer_Brand__ExpandableArrow-module__ExpandableArrow___aaZs9 Primer_Brand__Link-module__Link-arrow___yd78i" width="16" height="16" viewBox="0 0 16 16" fill="none" aria-hidden="true" focusable="false"><path fill="currentColor" d="M7.28033 3.21967C6.98744 2.92678 6.51256 2.92678 6.21967 3.21967C5.92678 3.51256 5.92678 3.98744 6.21967 4.28033L7.28033 3.21967ZM11 8L11.5303 8.53033C11.8232 8.23744 11.8232 7.76256 11.5303 7.46967L11 8ZM6.21967 11.7197C5.92678 12.0126 5.92678 12.4874 6.21967 12.7803C6.51256 13.0732 6.98744 13.0732 7.28033 12.7803L6.21967 11.7197ZM6.21967 4.28033L10.4697 8.53033L11.5303 7.46967L7.28033 3.21967L6.21967 4.28033ZM10.4697 7.46967L6.21967 11.7197L7.28033 12.7803L11.5303 8.53033L10.4697 7.46967Z"></path><path class="Primer_Brand__ExpandableArrow-module__ExpandableArrow-stem___0K8Hz" stroke="currentColor" d="M1.75 8H11" stroke-width="1.5" stroke-linecap="round"></path></svg></a></div></div></div></li><li><div class="NavDropdown-module__container__l2YeI"><button type="button" class="NavDropdown-module__button__PEHWX" aria-expanded="false" aria-controls="_R_17d_">Solutions<svg data-component="Octicon" aria-hidden="true" focusable="false" class="octicon octicon-triangle-right NavDropdown-module__buttonIcon__Tkl8_" viewBox="0 0 16 16" width="16" height="16" fill="currentColor" display="inline-block" overflow="visible" style="vertical-align:text-bottom"><path d="m6.427 4.427 3.396 3.396a.25.25 0 0 1 0 .354l-3.396 3.396A.25.25 0 0 1 6 11.396V4.604a.25.25 0 0 1 .427-.177Z"></path></svg></button><div id="_R_17d_" class="NavDropdown-module__dropdown__xm1jd"><ul class="NavDropdown-module__list__zuCgG"><li><div class="NavGroup-module__group__W8SqJ"><span class="Primer_Brand__Text-module__Text___XeGJJ Primer_Brand__Text-module__Text-font--monospace___QXHDQ Primer_Brand__Text-module__Text--muted___rE6mh Primer_Brand__Text-module__Text--100___B2ueX Primer_Brand__Text-module__Text--weight-medium___qJKf_ NavGroup-module__title__Wzxz2" id="_R_5l7d_">BY COMPANY SIZE</span><ul class="NavGroup-module__list__UCOFy" aria-labelledby="_R_5l7d_"><li><a
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
