triplo098/USB-to-Multipurpose-Framework-Expansion-Card/(list of files, cad)

Other CAD files:
3D_models/ExpansionCard.stl
usb_to_multipurpose/usb_to_multipurpose.stl
