triplo098/USB-to-Multipurpose-Framework-Expansion-Card/schematic_v1.0.pdf

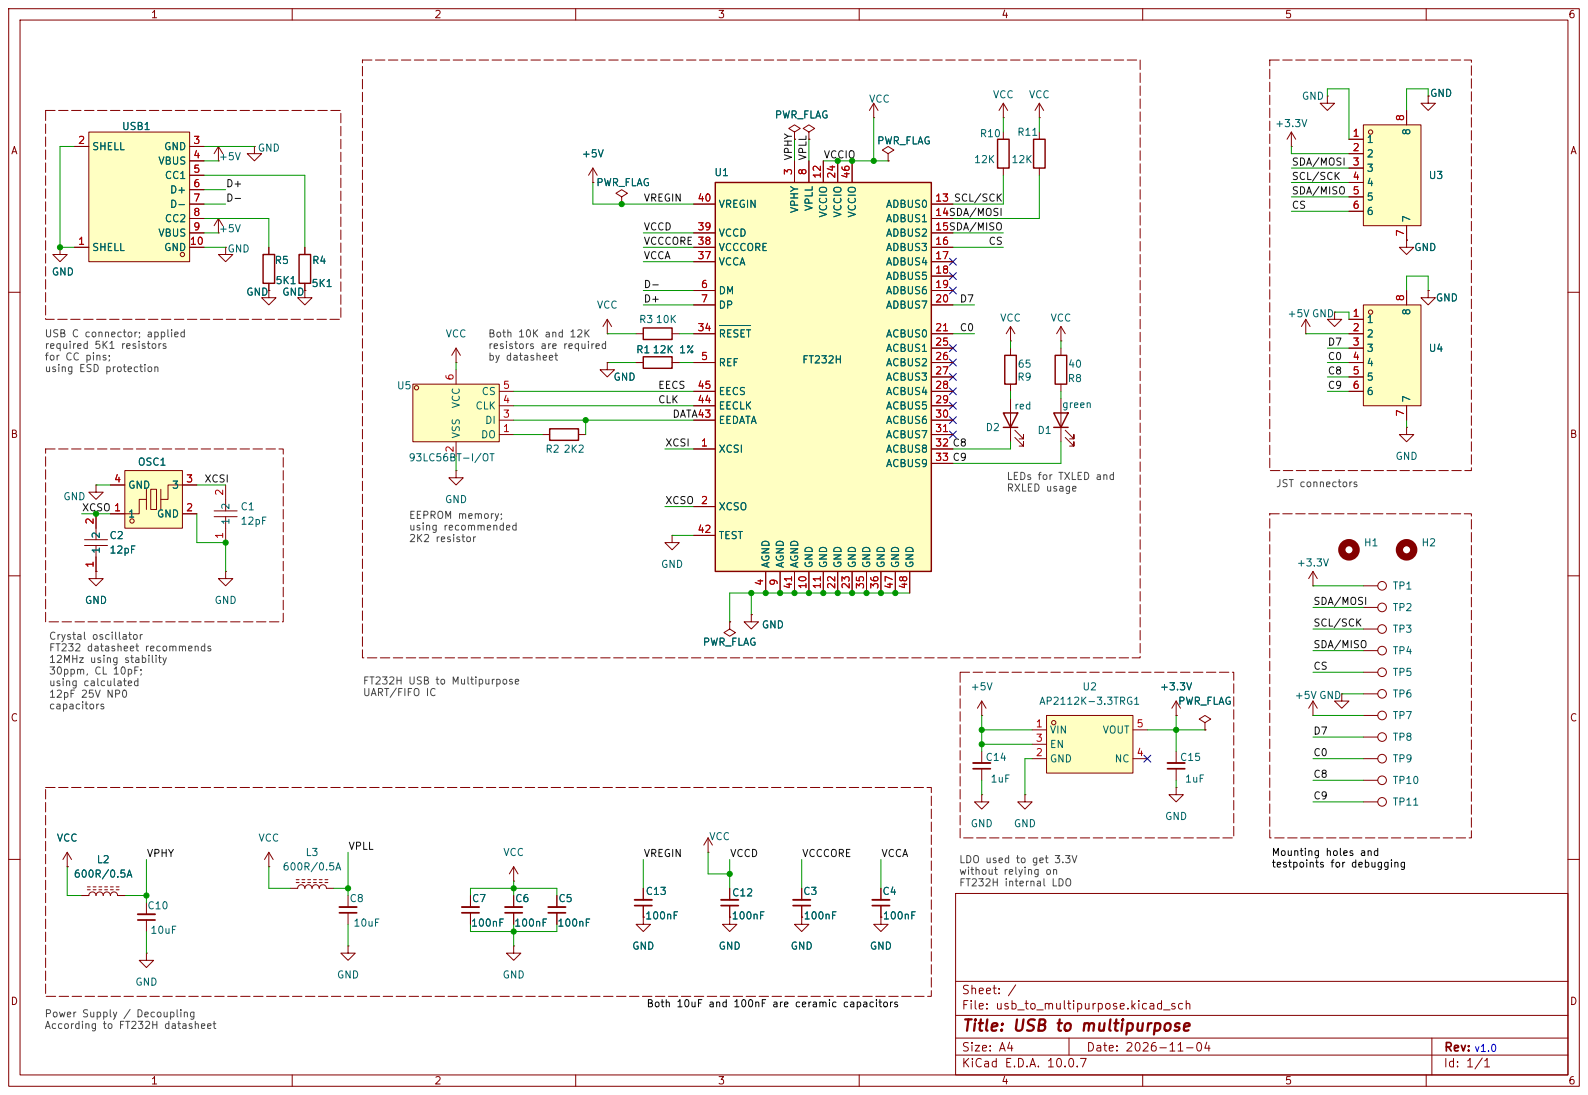
[picture p11: page 1]

4 REF 5 DM 6 DP 7 VPLL 8 AGND

Crystal oscillator FT232 datasheet recommends 12MHz using stability

Both 10uF and 100nF are ceramic capacitors

Sheet: /
File: usb_to_multipurpose.kicad_sch
Title: USB to multipurpose

Size: A4 | Rev:
KiCad E.D.A. 10.0.7 | Id: 1/1
