triplo098/USB-to-Multipurpose-Framework-Expansion-Card/usb_to_multipurpose/usb_to_multipurpose.kicad_pcb

## KiCad design usb_to_multipurpose/usb_to_multipurpose.kicad_pcb (2026-11-06)

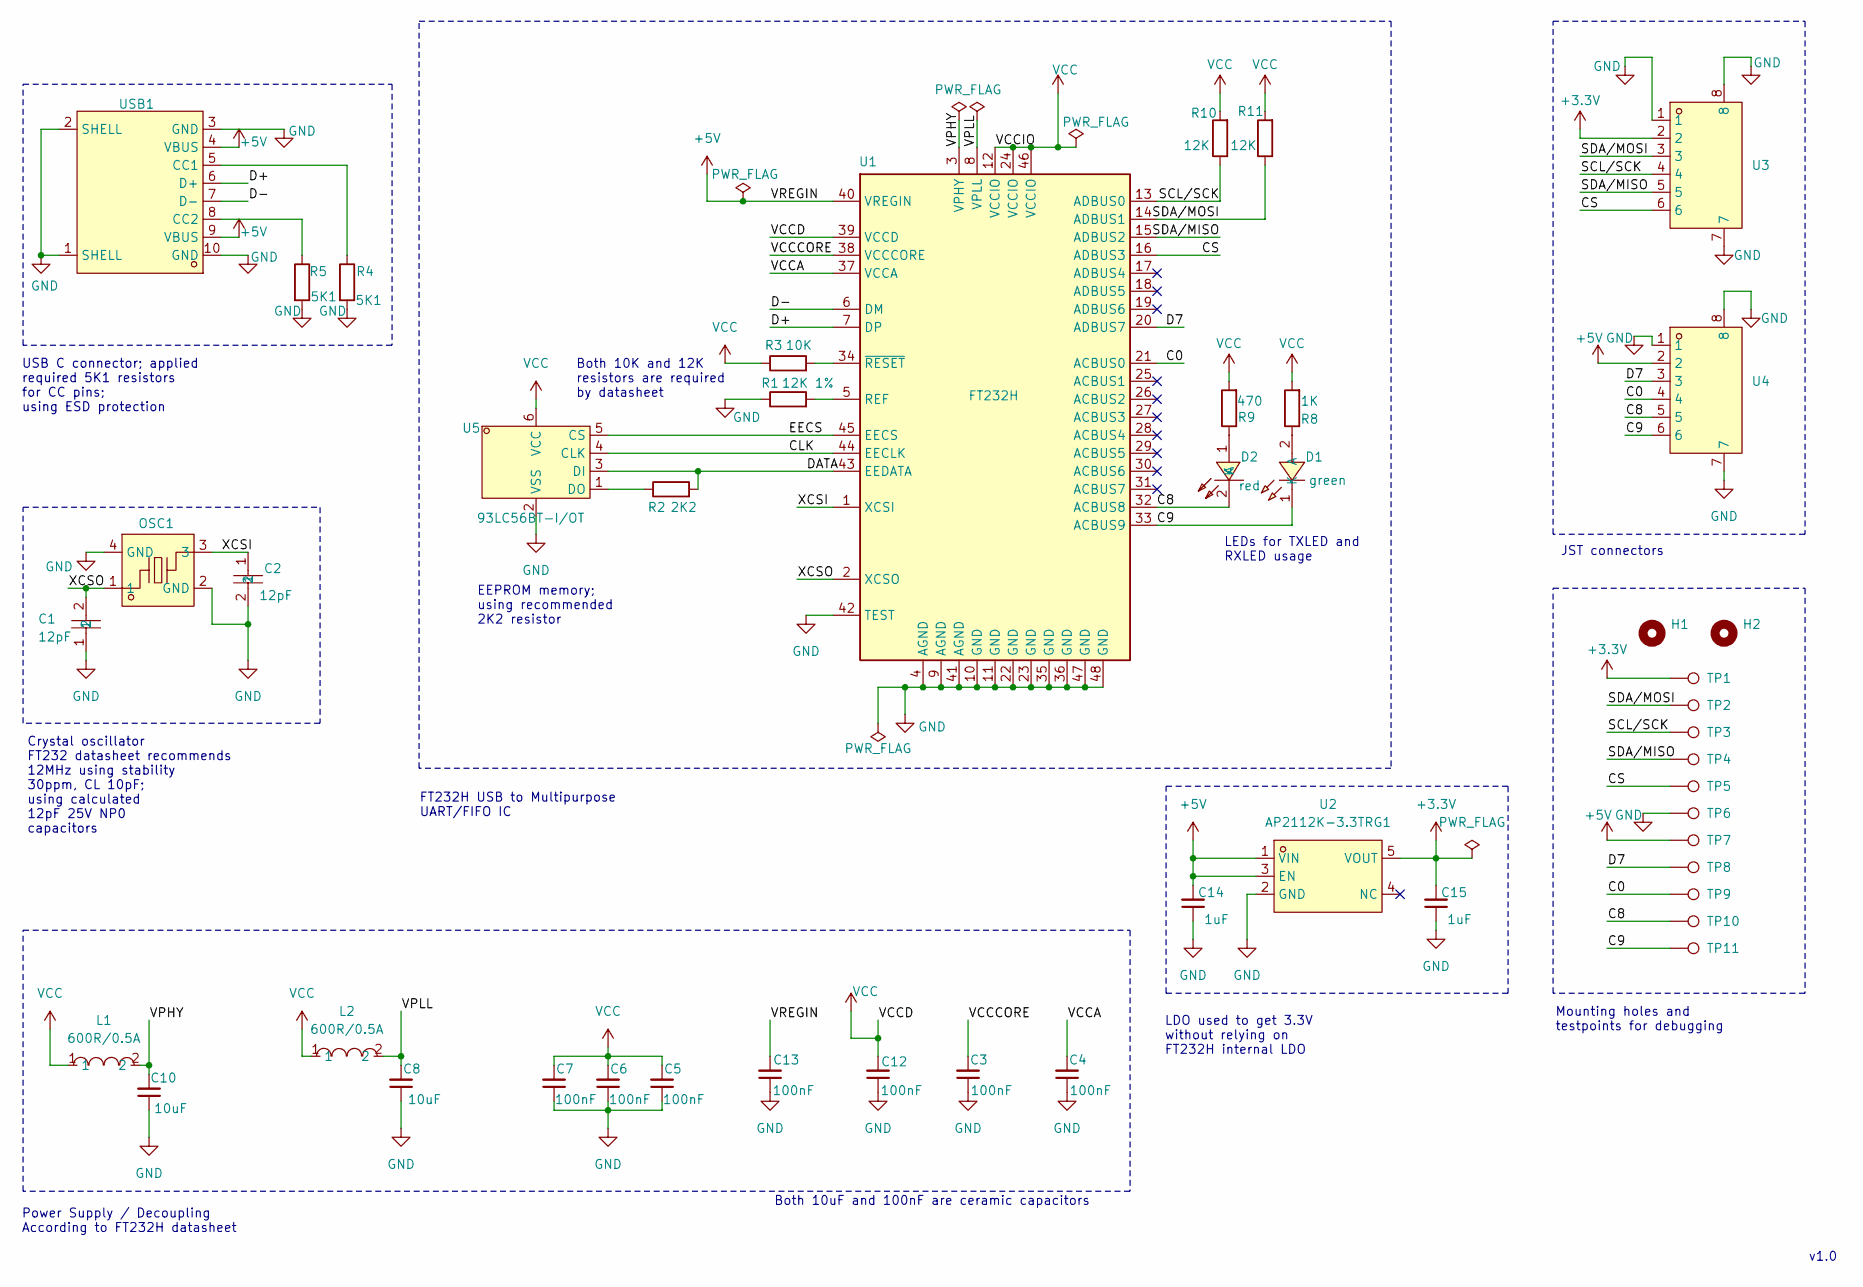
[picture p12: schematic usb_to_multipurpose.kicad_sch, USB to multipurpose]

Parts:
C1, C2: 12pF; C0402; MPN CC0402JRNPO9BN120; LCSC Part C106201
C3, C4, C5, C6, C7, C12, C13: 100nF; C0402
C8, C10: 10uF; C0603
C14, C15: 1uF; C0402
D1: green; LED0603-RD; MPN GL0603UG01; LCSC Part C51933293
D2: red; LED-SMD_L1.6-W0.8-R-RD; MPN KT-0603R; LCSC Part C2286
H1, H2: MountingHole; MountingHole_2.2mm_M2
L1, L2: 600R/0.5A; L0603; MPN BLM18EG601SN1D; LCSC Part C20345
OSC1: TX322512M4DBDE2T; OSC-SMD_4P-L3.2-W2.5-BL; MPN TX322512M4DBDE2T; LCSC Part C5310728
R1: 12K 1%; R0603
R2: 2K2; R0402
R3: 10K; R0402
R4, R5: 5K1; R0402
R8: 1K; R0603
R9: 470; R0603
R10, R11: 12K; R0603
TP1, TP2, TP3, TP4, TP5, TP6, TP7, TP8, TP9, TP10, TP11: TestPoint; TestPoint_Pad_1.0x1.0mm
U1: FT232H; LQFP-48_L7.0-W7.0-P0.50-LS9.0-TL
U2: AP2112K-3.3TRG1; SOT-23-5_L2.9-W1.6-P0.95-LS2.7-BR; MPN AP2112K-3.3TRG1(MS); LCSC Part C22365427
U3, U4: JST connector; CONN-SMD_SM06B-SRSS-TB-LF-SN; MPN SM06B-SRSS-TB(LF)(SN); LCSC Part C160405
U5: 93LC56BT-I/OT; SOT-23-6_L2.9-W1.6-P0.95-LS2.8-BR; MPN 93LC56BT-I/OT; LCSC Part C190271
USB1: HYCW675-USBC12-105B; USB-C-SMD_HYCW675-USBC12-105B; MPN HYCW675-USBC12-105B; LCSC Part C53436585

Connections:
+3.3V: C15.2, TP1.1 (1_1), U2.5 (VOUT), U3.2
+5V: C13.2, C14.2, TP7.1 (1_1), U1.40 (VREGIN), U2.1 (VIN), U2.3 (EN), U4.2, USB1.4 (VBUS), USB1.9 (VBUS)
/C0: TP9.1 (1_1), U1.21 (ACBUS0), U4.4
/C8: D2.2 (K), TP10.1 (1_1), U1.32 (ACBUS8), U4.5
/C9: D1.1 (K), TP11.1 (1_1), U1.33 (ACBUS9), U4.6
/CLK: U1.44 (EECLK), U5.4 (CLK)
/CS: TP5.1 (1_1), U1.16 (ADBUS3), U3.6
/D7: TP8.1 (1_1), U1.20 (ADBUS7), U4.3
/D+: U1.7 (DP), USB1.6 (D+)
/D-: U1.6 (DM), USB1.7 (D-)
/DATA: R2.2, U1.43 (EEDATA), U5.3 (DI)
/EECS: U1.45 (EECS), U5.5 (CS)
/SCL/SCK: R10.1, TP3.1 (1_1), U1.13 (ADBUS0), U3.4
/SDA/MISO: TP4.1 (1_1), U1.15 (ADBUS2), U3.5
/SDA/MOSI: R11.1, TP2.1 (1_1), U1.14 (ADBUS1), U3.3
/VCCA: C4.2, U1.37 (VCCA)
/VCCCORE: C3.2, U1.38 (VCCCORE)
/VPHY: C10.2, L1.2, U1.3 (VPHY)
/VPLL: C8.2, L2.2, U1.8 (VPLL)
/XCSI: C2.1, OSC1.3, U1.1 (XCSI)
/XCSO: C1.2, OSC1.1, U1.2 (XCSO)
GND: C1.1, C2.2, C3.1, C4.1, C5.1, C6.1, C7.1, C8.1, C10.1, C12.1, C13.1, C14.1, C15.1, OSC1.2 (GND), OSC1.4 (GND), R1.1, R4.2, R5.2, TP6.1 (1_1), U1.4 (AGND), U1.9 (AGND), U1.10 (GND), U1.11 (GND), U1.22 (GND), U1.23 (GND), U1.35 (GND), U1.36 (GND), U1.41 (AGND), U1.42 (TEST), U1.47 (GND), U1.48 (GND), U2.2 (GND), U3.1, U3.7, U3.8, U4.1, U4.7, U4.8, U5.2 (VSS), USB1.1 (SHELL), USB1.2 (SHELL), USB1.3 (GND), USB1.10 (GND)
unnamed: D1.2 (A), R8.1
unnamed: D2.1 (A), R9.1
unnamed: R1.2, U1.5 (REF)
unnamed: R3.2, U1.34 (~RESET)
unnamed: R2.1, U5.1 (DO)
unnamed: R4.1, USB1.5 (CC1)
unnamed: R5.1, USB1.8 (CC2)
VCC: C5.2, C6.2, C7.2, C12.2, L1.1, L2.1, R3.1, R8.2, R9.2, R10.2, R11.2, U1.12 (VCCIO), U1.24 (VCCIO), U1.39 (VCCD), U1.46 (VCCIO), U5.6 (VCC)

Notes on the sheet:
LEDs for TXLED and RXLED usage
v1.0
JST connectors
Mounting holes and testpoints for debugging
FT232H USB to Multipurpose UART/FIFO IC
Power Supply / Decoupling According to FT232H datasheet
USB C connector; applied required 5K1 resistors for CC pins; using ESD protection
Crystal oscillator FT232 datasheet recommends 12MHz using stability 30ppm, CL 10pF; using calculated 12pF 25V NP0 capacitors
Both 10K and 12K resistors are required by datasheet
EEPROM memory; using recommended 2K2 resistor
LDO used to get 3.3V without relying on FT232H internal LDO
Both 10uF and 100nF are ceramic capacitors

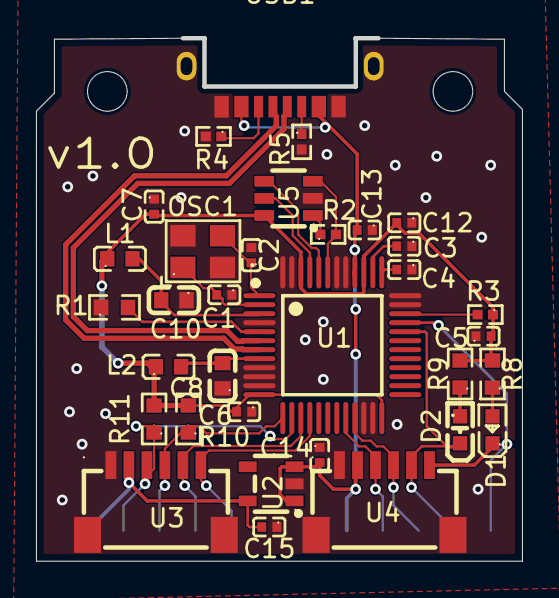
[picture p13: board usb_to_multipurpose.kicad_pcb from above]

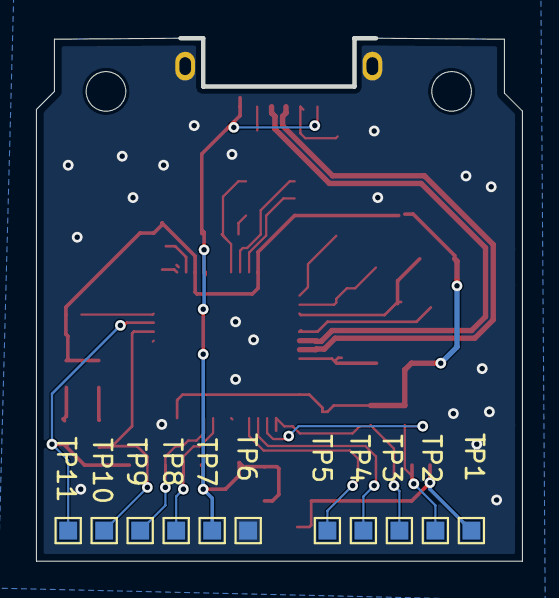
[picture p14: board usb_to_multipurpose.kicad_pcb from below]

Board: 2 copper layers, 27.0 x 29.1 mm, 46 parts (11 on the bottom side), 30 nets.
