triplo098/USB-to-Multipurpose-Framework-Expansion-Card/(commit log)

2026-08-27 Initial commit. Add schematic for the FT232 framework expansion card.
    [usb_to_multipurpose.kicad_pcb, usb_to_multipurpose.kicad_sch]
2026-08-28 Update schematic for self-powered configuration running on 3.3V. Added footprints.
    [usb_to_multipurpose.kicad_pcb, usb_to_multipurpose.kicad_sch]
2026-08-29 Add 2*8 header. Schematic cleanup.
    [usb_to_multipurpose.kicad_pcb, usb_to_multipurpose.kicad_sch]
2026-09-06 Schematic refinements. Add schematic info.
    [usb_to_multipurpose.kicad_pcb, usb_to_multipurpose.kicad_sch]
2026-09-10 Improve and define PCB shape to fit the case. Add case model.
    [base.FCStd, usb_to_multipurpose.kicad_pcb]
2026-09-14 Prepare v1.0 of the PCB.
    [base.FCStd, usb_to_multipurpose.kicad_pcb, usb_to_multipurpose.kicad_sch]
2026-09-15 Change connector for smaller JST SH 2x6 pin.
    [usb_to_multipurpose.kicad_pcb, usb_to_multipurpose.kicad_sch]
2026-09-16 Add 3D models, case update.
    [ExpansionCard.scad, ExpansionCard.stl, base.FCStd]
2026-11-04 Add comments and improve readability of the schematic
2026-11-04 Update schematic with added testpoints and mountholes. Update PCB layout and fix mistakes.
2026-11-04 Update schematic pdf. Create differential pair for USB traces.
2026-11-10 Update expansion card case 3D model, render and README.
